fabriciomicheldenes/Momea/(list of files, drawings)

Other design files:
MomeaProbe12/Ae_System_12Bits_V5.dsn
