fabriciomicheldenes/Momea/MomeaProbe12/Amplificador.kicad_sch

## KiCad design MomeaProbe12/Amplificador.kicad_sch (2024-12-18)

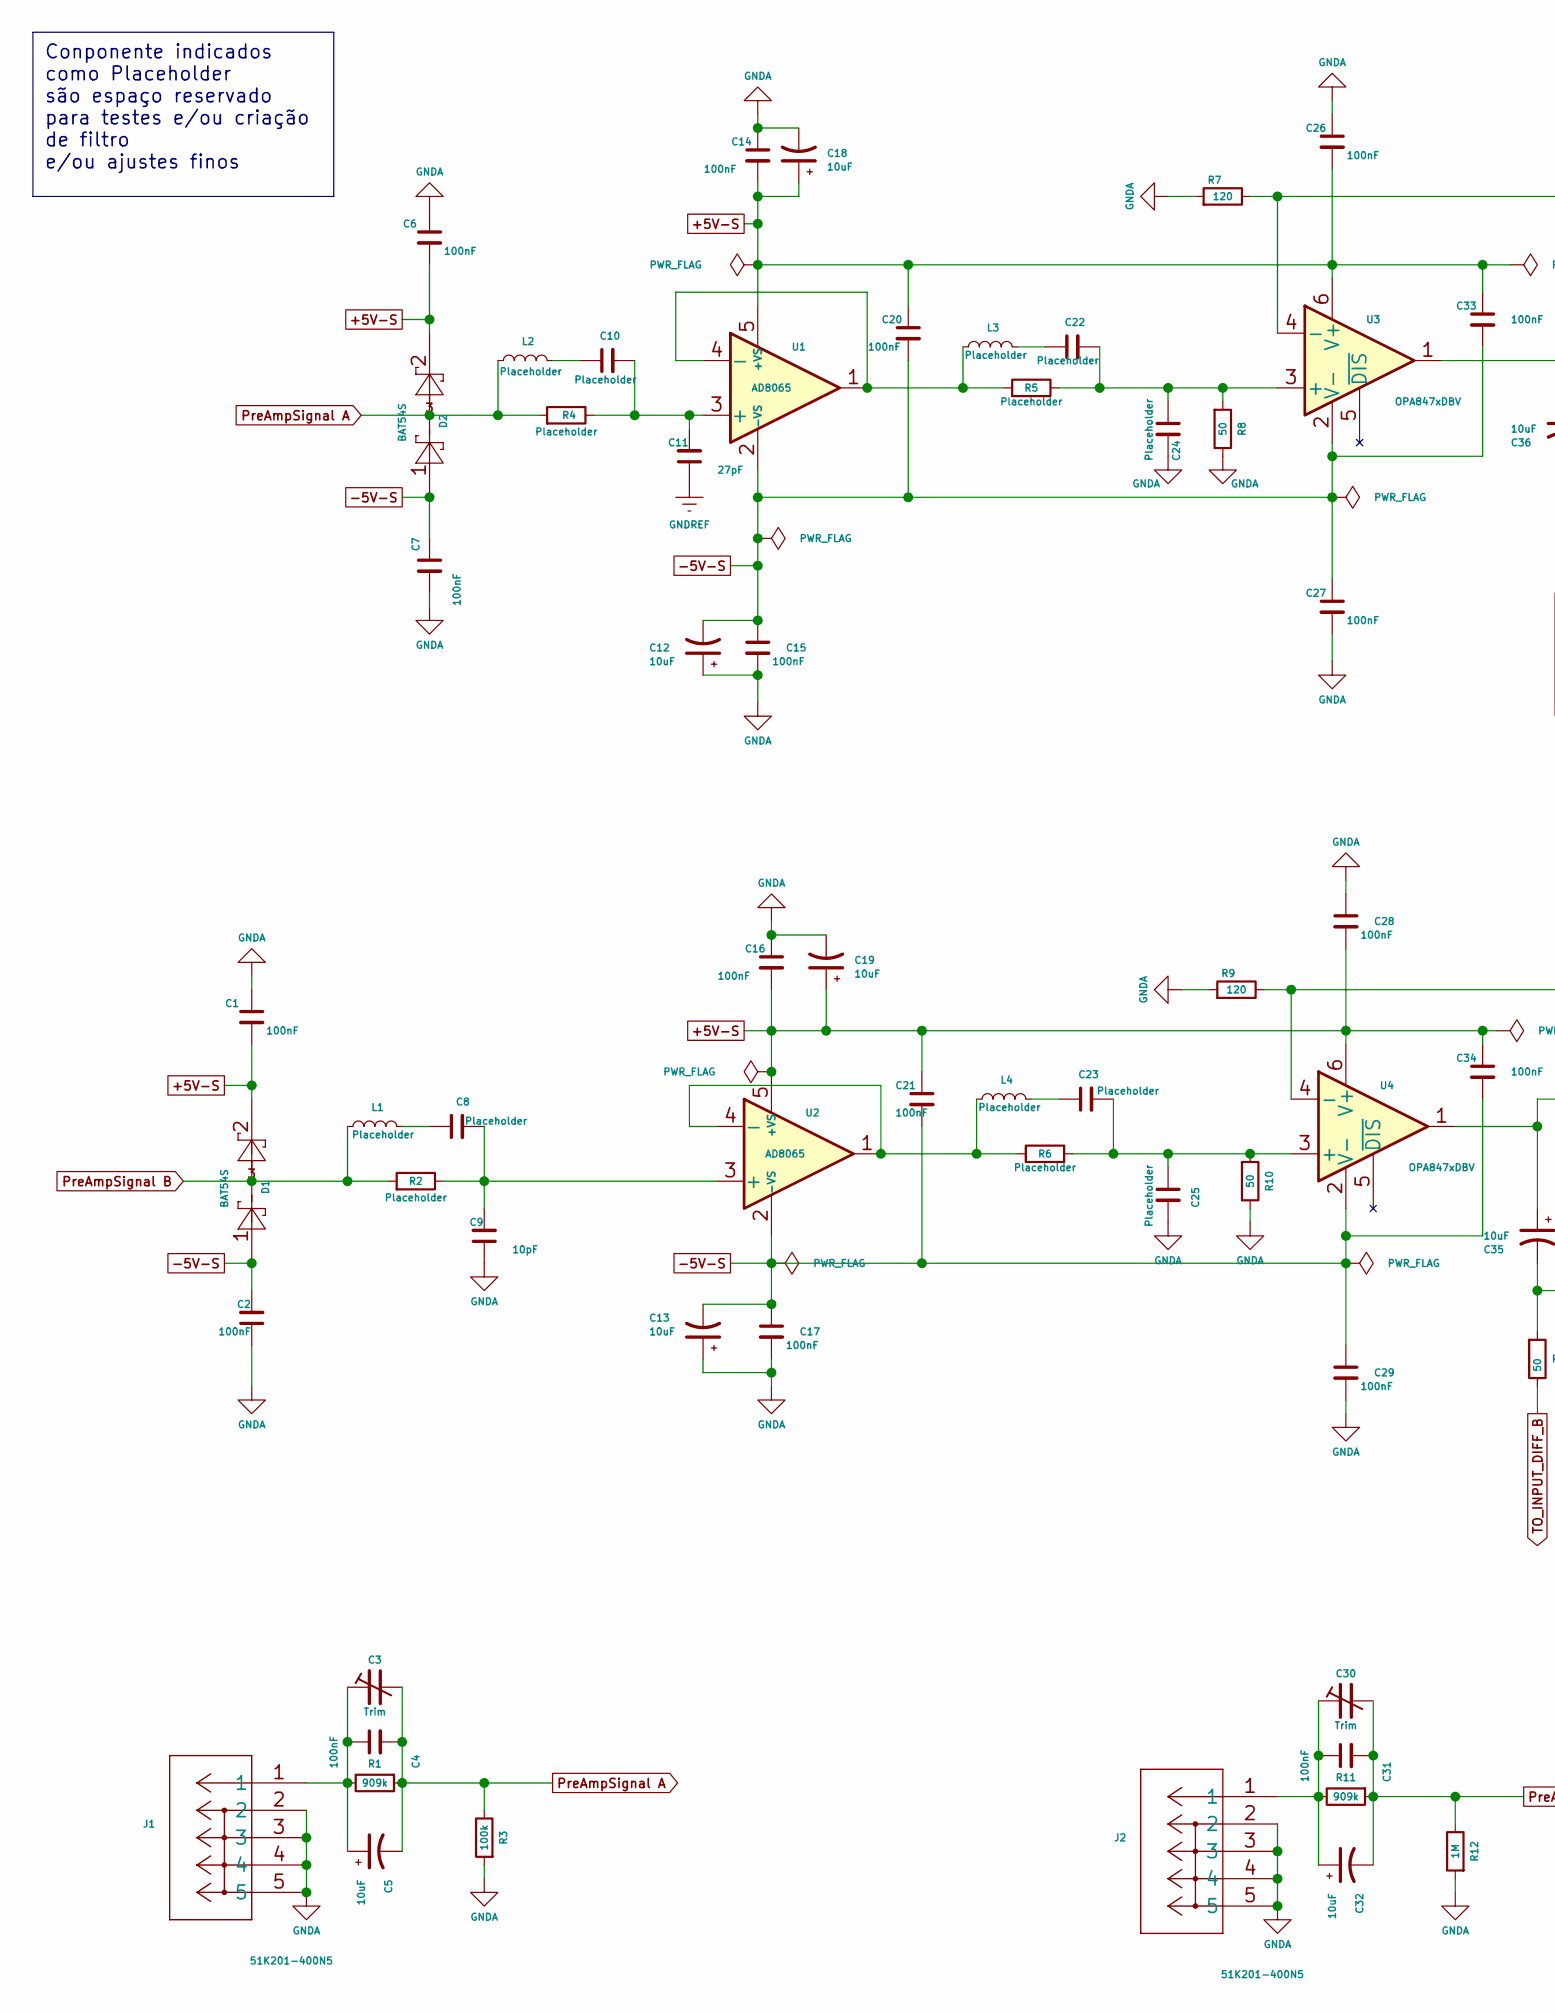
[picture p1: schematic Amplificador.kicad_sch, part in row 1, column 1]

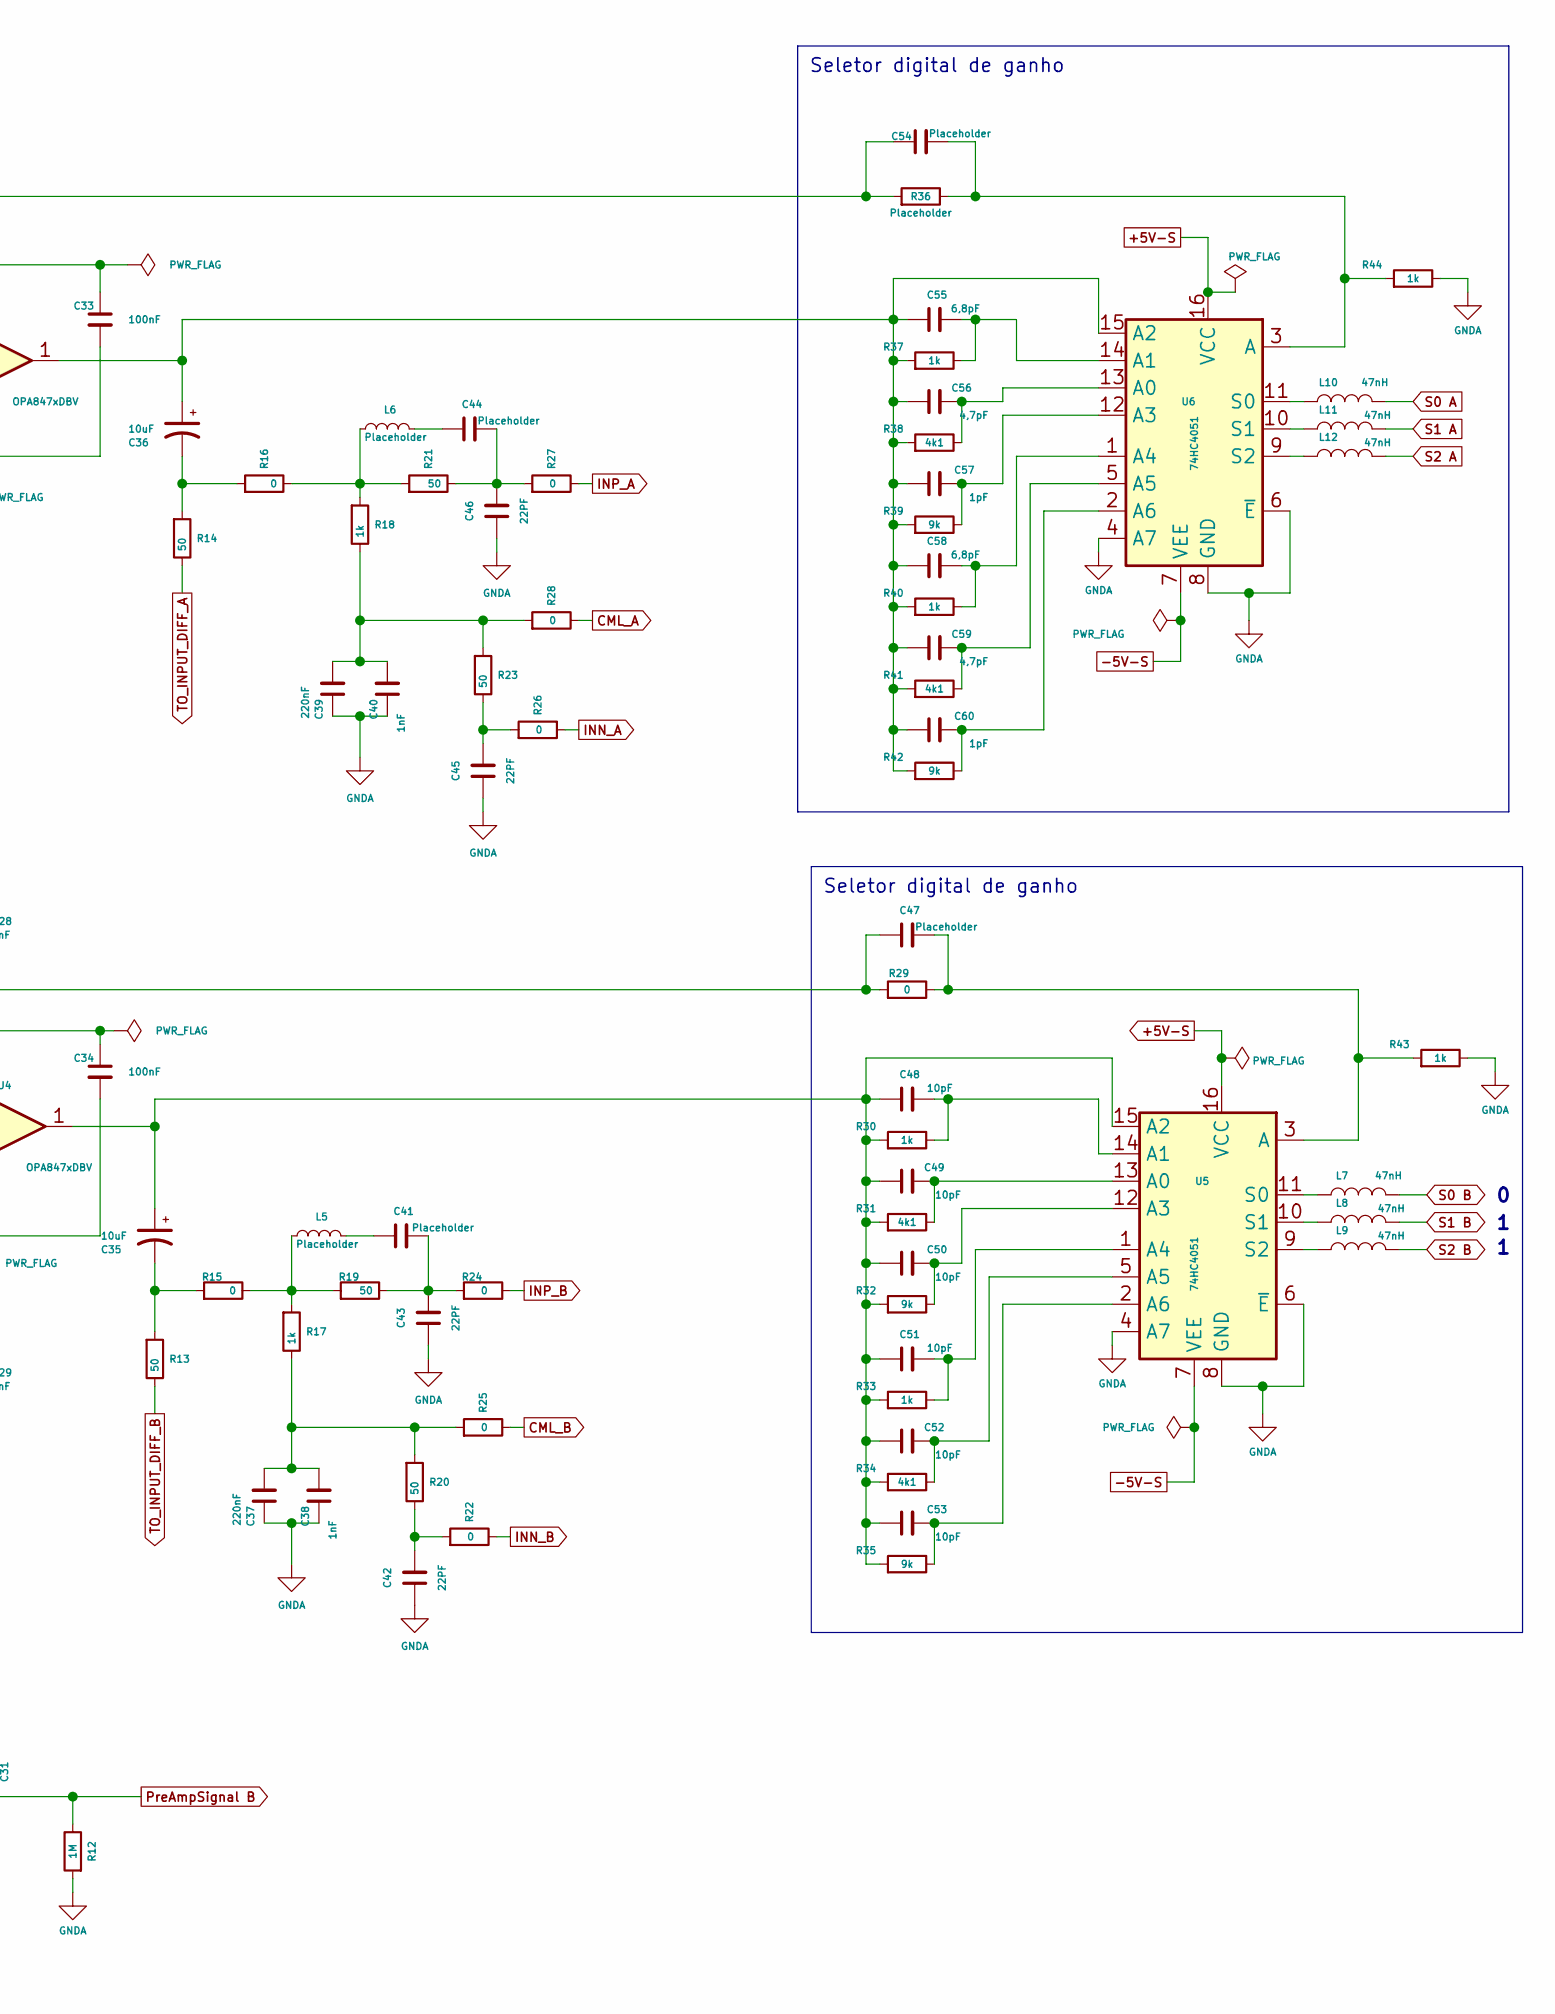
[picture p2: schematic Amplificador.kicad_sch, part in row 1, column 2]

Parts:
C1, C2, C4, C6, C7, C14, C15, C16, C17, C20, C21, C26, C27, C28, C29, C31, C33, C34: 100nF; C_0603_1608Metric
C3, C30: Trim; C_Trimmer_Murata_TZB4-B
C5, C12, C13, C18, C19, C32, C35, C36: 10uF; CP_Elec_4x3.9
C8, C10, C22, C23, C24, C25, C41, C44, C47, C54: Placeholder; C_0603_1608Metric
C9, C48, C49, C50, C51, C52, C53: 10pF; C_0603_1608Metric
C11: 27pF; C_0603_1608Metric
C37: 220nF; C_0603_1608Metric
C38, C40: 1nF; C_0603_1608Metric
C39: 220nF; C_0805_2012Metric
C42, C43, C45, C46: 22PF; C_0603_1608Metric
C55, C58: 6,8pF; C_0603_1608Metric
C56, C59: 4,7pF; C_0603_1608Metric
C57, C60: 1pF; C_0603_1608Metric
D1, D2: BAT54S; SOT-23
J1, J2: 51K201-400N5; CONN_51K201-400N5_RBG
L1, L2, L3, L4, L5, L6: Placeholder; L_0805_2012Metric
L7, L8, L9, L10, L11, L12: 47nH; L_0805_2012Metric
R1, R11: 909k; R_0603_1608Metric
R2, R4, R5, R6, R36: Placeholder; R_0603_1608Metric
R3: 100k; R_0603_1608Metric
R7, R9: 120; R_0603_1608Metric
R8, R10, R13, R14, R19, R20, R21, R23: 50; R_0603_1608Metric
R12: 1M; R_0603_1608Metric
R15, R16, R22, R24, R25, R26, R27, R28, R29: 0; R_0603_1608Metric
R17, R18, R30, R33, R37, R40, R43, R44: 1k; R_0603_1608Metric
R31, R34, R38, R41: 4k1; R_0603_1608Metric
R32, R35, R39, R42: 9k; R_0603_1608Metric
U1, U2: AD8065; AD8065ARTZ-R2
U3, U4: OPA847xDBV; SOT-23-6
U5, U6: 74HC4051; SOIC-16_4.55x10.3mm_P1.27mm

Connections:
+5V-S: C1.2, C6.2, C14.2, C16.2, C18.1, C19.1, C20.1, C21.1, C26.2, C28.2, C33.1, C34.1, D1.2, D2.2, U1.5 (+VS), U2.5 (+VS), U3.6 (V+), U4.6 (V+), U5.16 (VCC), U6.16 (VCC)
-5V-S: C2.2, C7.1, C12.2, C13.2, C15.1, C17.1, C20.2, C21.2, C27.1, C29.1, C33.2, C34.2, D1.1, D2.1, U1.2 (-VS), U2.2 (-VS), U3.2 (V-), U4.2 (V-), U5.7 (VEE), U6.7 (VEE)
CML_A: R28.2
CML_B: R25.2
GNDA: C1.1, C2.1, C6.1, C7.2, C9.1, C12.1, C13.1, C14.1, C15.2, C16.1, C17.2, C18.2, C19.2, C24.2, C25.2, C26.1, C27.2, C28.1, C29.2, C37.1, C38.1, C39.1, C40.1, C42.1, C43.1, C45.1, C46.1, J1.2, J1.3, J1.4, J1.5, J2.2, J2.3, J2.4, J2.5, R3.1, R7.1, R8.2, R9.1, R10.2, R12.1, R43.2, R44.2, U5.4 (A7), U5.6 (~E), U5.8 (GND), U6.4 (A7), U6.6 (~E), U6.8 (GND)
GNDREF: C11.1
INN_A: R26.2
INN_B: R22.2
INP_A: R27.2
INP_B: R24.2
unnamed: C3.1, C4.1, C5.1, J1.1, R1.2
unnamed: C8.1, L1.2
unnamed: C8.2, C9.2, R2.2, U2.3 (+)
unnamed: C10.1, L2.2
unnamed: C10.2, C11.2, R4.2, U1.3 (+)
unnamed: C22.1, L3.2
unnamed: C22.2, C24.1, R5.2, R8.1, U3.3 (+)
unnamed: C23.1, L4.2
unnamed: C23.2, C25.1, R6.2, R10.1, U4.3 (+)
unnamed: C30.1, C31.1, C32.1, J2.1, R11.2
unnamed: C35.1, C48.1, C49.1, C50.1, C51.1, C52.1, C53.1, R30.1, R31.1, R32.1, R33.1, R34.1, R35.1, U4.1, U5.15 (A2)
unnamed: C35.2, R13.1, R15.1
unnamed: C36.1, C55.1, C56.1, C57.1, C58.1, C59.1, C60.1, R37.1, R38.1, R39.1, R40.1, R41.1, R42.1, U3.1, U6.15 (A2)
unnamed: C36.2, R14.1, R16.1
unnamed: C37.2, C38.2, R17.2, R20.1, R25.1
unnamed: C39.2, C40.2, R18.2, R23.1, R28.1
unnamed: C41.1, L5.2
unnamed: C41.2, C43.2, R19.2, R24.1
unnamed: C42.2, R20.2, R22.1
unnamed: C44.1, L6.2
unnamed: C44.2, C46.2, R21.2, R27.1
unnamed: C45.2, R23.2, R26.1
unnamed: C47.1, R9.2, R29.1, U4.4 (-)
unnamed: C47.2, R29.2, R43.1, U5.3 (A)
unnamed: C48.2, R30.2, U5.14 (A1)
unnamed: C49.2, R31.2, U5.13 (A0)
unnamed: C50.2, R32.2, U5.12 (A3)
unnamed: C51.2, R33.2, U5.1 (A4)
unnamed: C52.2, R34.2, U5.5 (A5)
unnamed: C53.2, R35.2, U5.2 (A6)
unnamed: C54.1, R7.2, R36.1, U3.4 (-)
unnamed: C54.2, R36.2, R44.1, U6.3 (A)
unnamed: C55.2, R37.2, U6.14 (A1)
unnamed: C56.2, R38.2, U6.13 (A0)
unnamed: C57.2, R39.2, U6.12 (A3)
unnamed: C58.2, R40.2, U6.1 (A4)
unnamed: C59.2, R41.2, U6.5 (A5)
unnamed: C60.2, R42.2, U6.2 (A6)
unnamed: L3.1, R5.1, U1.1, U1.4 (-)
unnamed: L4.1, R6.1, U2.1, U2.4 (-)
unnamed: L5.1, R15.2, R17.1, R19.1
unnamed: L6.1, R16.2, R18.1, R21.1
unnamed: L7.1, U5.11 (S0)
unnamed: L8.1, U5.10 (S1)
unnamed: L9.1, U5.9 (S2)
unnamed: L10.1, U6.11 (S0)
unnamed: L11.1, U6.10 (S1)
unnamed: L12.1, U6.9 (S2)
PreAmpSignal A: C3.2, C4.2, C5.2, D2.3, L2.1, R1.1, R3.2, R4.1
PreAmpSignal B: C30.2, C31.2, C32.2, D1.3, L1.1, R2.1, R11.1, R12.2
S0 A: L10.2
S0 B: L7.2
S1 A: L11.2
S1 B: L8.2
S2 A: L12.2
S2 B: L9.2
TO_INPUT_DIFF_A: R14.2
TO_INPUT_DIFF_B: R13.2

Notes on the sheet:
Seletor digital de ganho
Conponente indicados como Placeholder são espaço reservado para testes e/ou criação de filtro e/ou ajustes finos
