fabriciomicheldenes/Momea/MomeaProbe12/ConversorAnalogicoDigital.kicad_sch

## KiCad design MomeaProbe12/ConversorAnalogicoDigital.kicad_sch (2024-12-18)

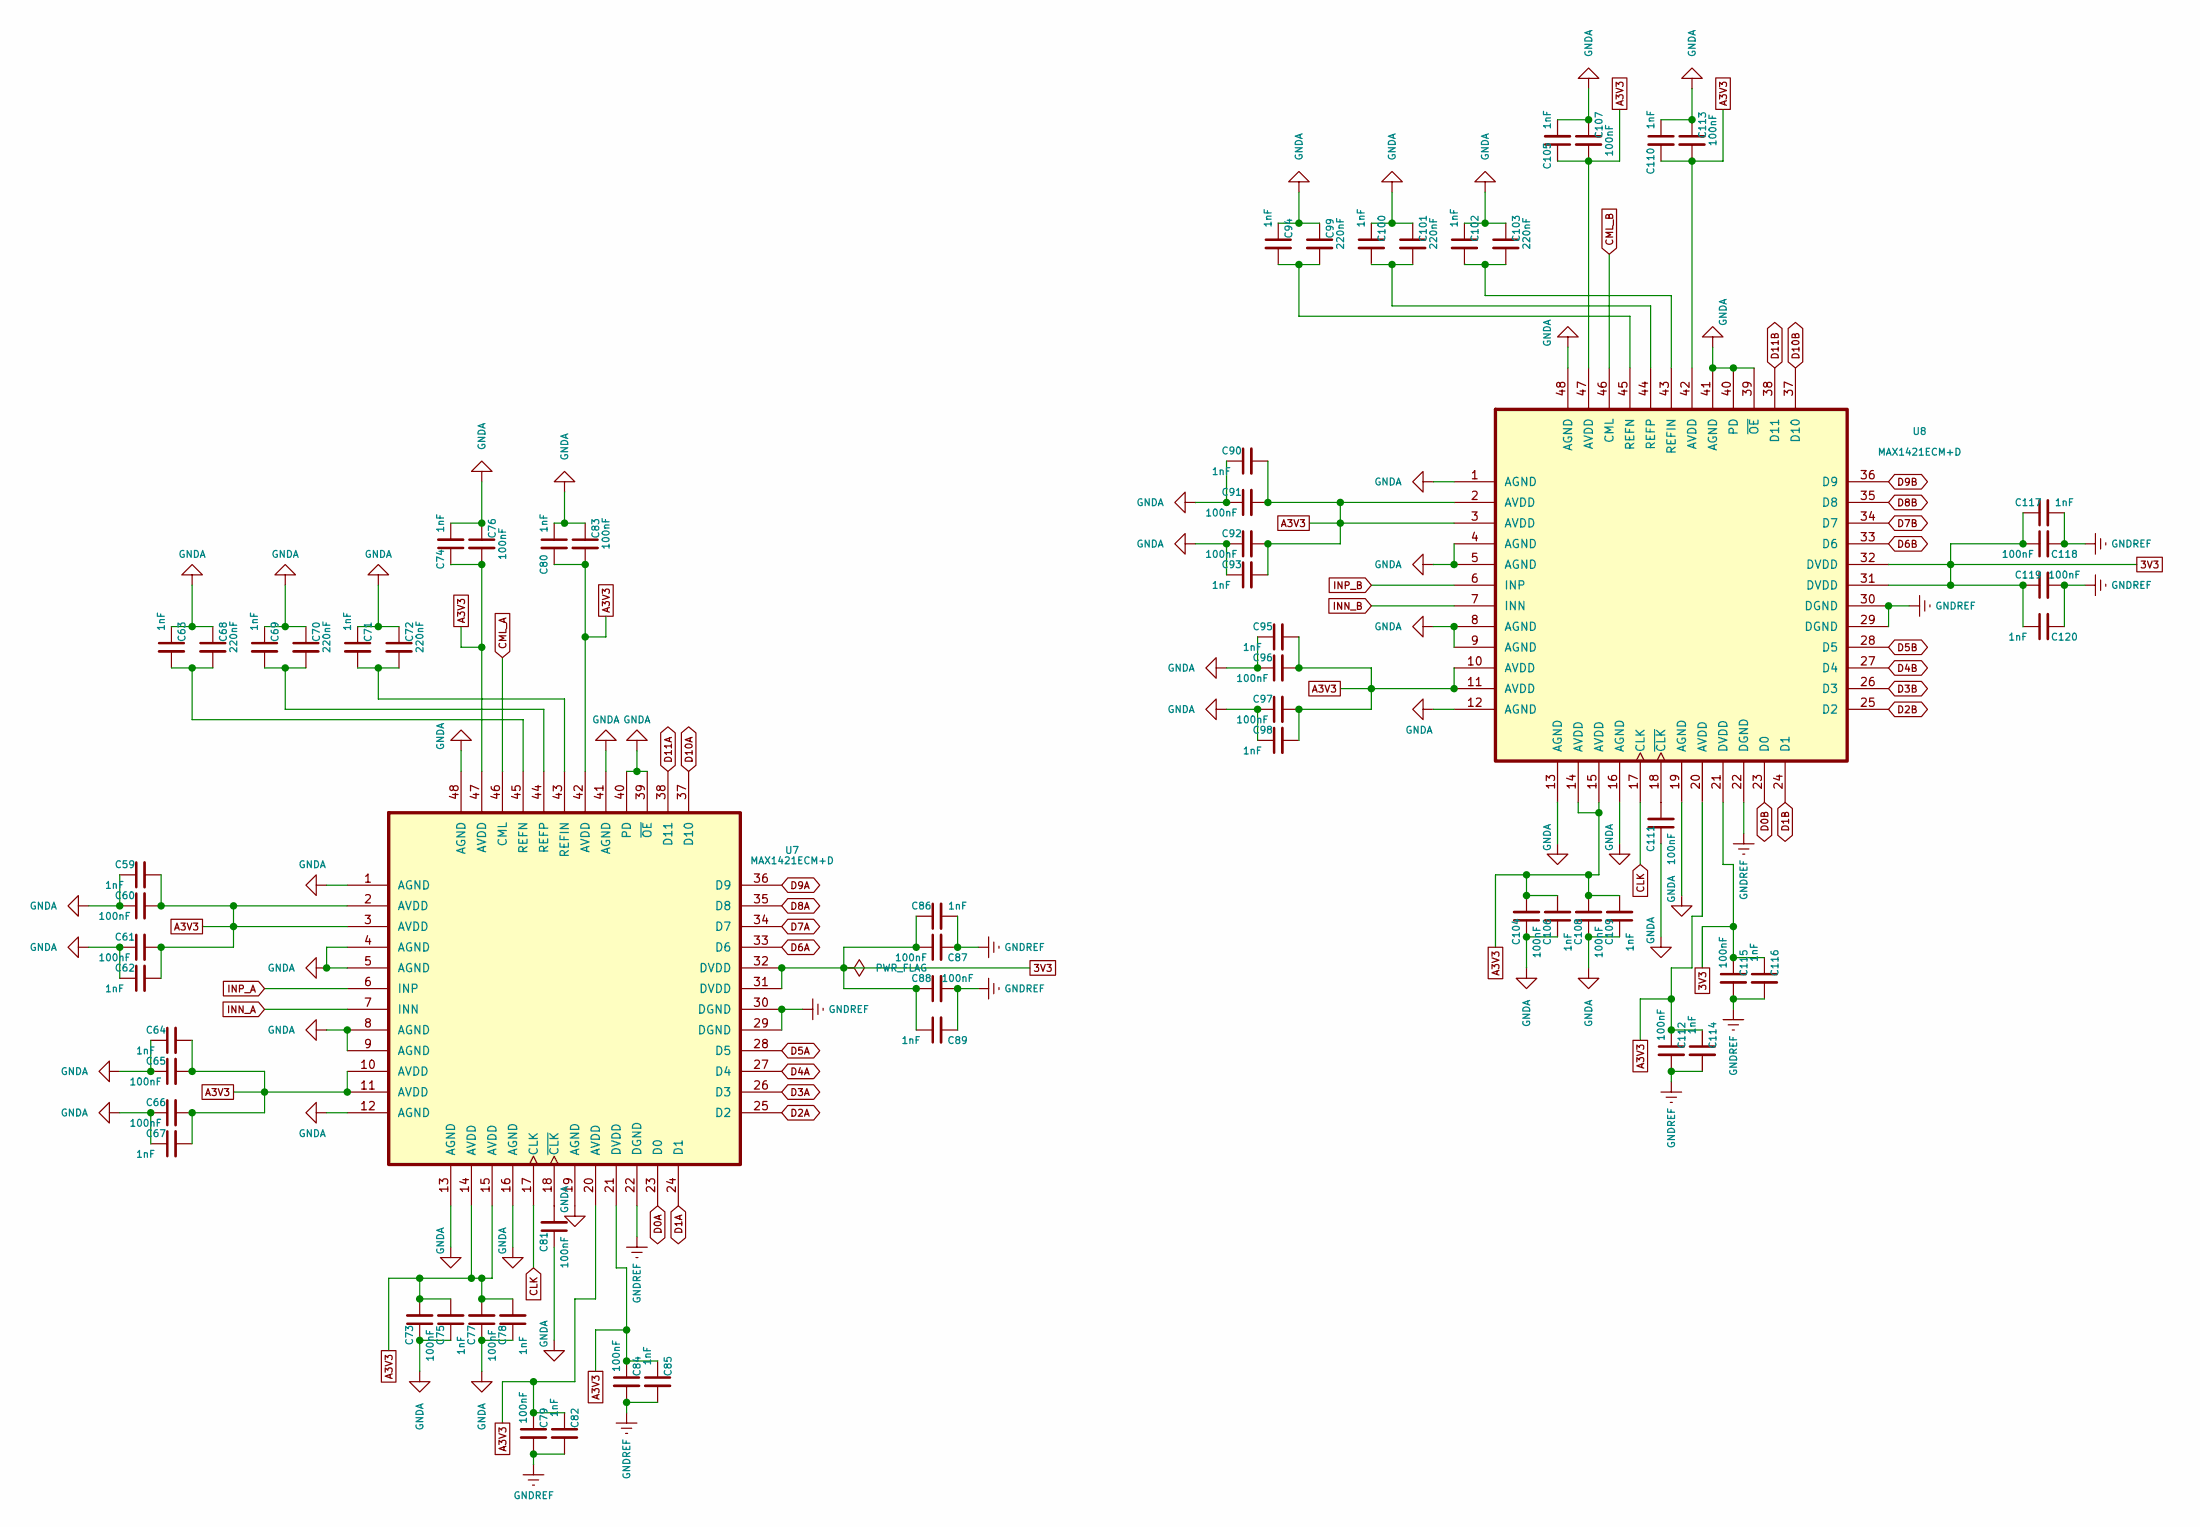
[picture p3: schematic ConversorAnalogicoDigital.kicad_sch]

Parts:
C59, C62, C63, C64, C67, C69, C71, C74, C75, C78, C80, C82, C85, C86, C89, C90, C93, C94, C95, C98, C100, C102, C105, C106, C109, C110, C114, C116, C117, C120: 1nF; C_0603_1608Metric
C60, C61, C65, C66, C73, C76, C77, C79, C81, C83, C84, C87, C88, C91, C92, C96, C97, C104, C107, C108, C111, C112, C113, C115, C118, C119: 100nF; C_0603_1608Metric
C68, C70, C72, C99, C101, C103: 220nF; C_0805_2012Metric
U7, U8: MAX1421ECM+D; QFP50P900X900X160-48N

Connections:
3V3: C86.1, C87.1, C88.1, C89.1, C115.1, C116.1, C117.1, C118.1, C119.1, C120.1, U7.31 (DVDD), U7.32 (DVDD), U8.21 (DVDD), U8.31 (DVDD), U8.32 (DVDD)
A3V3: C59.2, C60.2, C61.2, C62.2, C64.2, C65.2, C66.2, C67.2, C73.2, C74.1, C75.2, C76.2, C77.2, C78.2, C79.1, C80.2, C82.1, C83.2, C84.1, C85.1, C90.2, C91.2, C92.2, C93.2, C95.2, C96.2, C97.2, C98.2, C104.2, C105.1, C106.2, C107.2, C108.2, C109.2, C110.2, C112.1, C113.2, C114.1, U7.2 (AVDD), U7.3 (AVDD), U7.10 (AVDD), U7.11 (AVDD), U7.14 (AVDD), U7.15 (AVDD), U7.20 (AVDD), U7.21 (DVDD), U7.42 (AVDD), U7.47 (AVDD), U8.2 (AVDD), U8.3 (AVDD), U8.10 (AVDD), U8.11 (AVDD), U8.14 (AVDD), U8.15 (AVDD), U8.20 (AVDD), U8.42 (AVDD), U8.47 (AVDD)
CLK: U7.17 (CLK), U8.17 (CLK)
CML_A: U7.46 (CML)
CML_B: U8.46 (CML)
D0A: U7.23 (D0)
D0B: U8.23 (D0)
D1A: U7.24 (D1)
D1B: U8.24 (D1)
D2A: U7.25 (D2)
D2B: U8.25 (D2)
D3A: U7.26 (D3)
D3B: U8.26 (D3)
D4A: U7.27 (D4)
D4B: U8.27 (D4)
D5A: U7.28 (D5)
D5B: U8.28 (D5)
D6A: U7.33 (D6)
D6B: U8.33 (D6)
D7A: U7.34 (D7)
D7B: U8.34 (D7)
D8A: U7.35 (D8)
D8B: U8.35 (D8)
D9A: U7.36 (D9)
D9B: U8.36 (D9)
D10A: U7.37 (D10)
D10B: U8.37 (D10)
D11A: U7.38 (D11)
D11B: U8.38 (D11)
GNDA: C59.1, C60.1, C61.1, C62.1, C63.1, C64.1, C65.1, C66.1, C67.1, C68.1, C69.1, C70.1, C71.1, C72.1, C73.1, C74.2, C75.1, C76.1, C77.1, C78.1, C80.1, C81.1, C83.1, C90.1, C91.1, C92.1, C93.1, C94.1, C95.1, C96.1, C97.1, C98.1, C99.1, C100.1, C101.1, C102.1, C103.1, C104.1, C105.2, C106.1, C107.1, C108.1, C109.1, C110.1, C111.1, C113.1, U7.1 (AGND), U7.4 (AGND), U7.5 (AGND), U7.8 (AGND), U7.9 (AGND), U7.12 (AGND), U7.13 (AGND), U7.16 (AGND), U7.19 (AGND), U7.39 (~OE), U7.40 (PD), U7.41 (AGND), U7.48 (AGND), U8.1 (AGND), U8.4 (AGND), U8.5 (AGND), U8.8 (AGND), U8.9 (AGND), U8.12 (AGND), U8.13 (AGND), U8.16 (AGND), U8.19 (AGND), U8.39 (~OE), U8.40 (PD), U8.41 (AGND), U8.48 (AGND)
GNDREF: C79.2, C82.2, C84.2, C85.2, C86.2, C87.2, C88.2, C89.2, C112.2, C114.2, C115.2, C116.2, C117.2, C118.2, C119.2, C120.2, U7.22 (DGND), U7.29 (DGND), U7.30 (DGND), U8.22 (DGND), U8.29 (DGND), U8.30 (DGND)
INN_A: U7.7 (INN)
INN_B: U8.7 (INN)
INP_A: U7.6 (INP)
INP_B: U8.6 (INP)
unnamed: C63.2, C68.2, U7.45 (REFN)
unnamed: C69.2, C70.2, U7.44 (REFP)
unnamed: C71.2, C72.2, U7.43 (REFIN)
unnamed: C81.2, U7.18 (~CLK)
unnamed: C94.2, C99.2, U8.45 (REFN)
unnamed: C100.2, C101.2, U8.44 (REFP)
unnamed: C102.2, C103.2, U8.43 (REFIN)
unnamed: C111.2, U8.18 (~CLK)
