fabriciomicheldenes/Momea/MomeaProbe12/ConversorAnalogicoDigital_A.kicad_sch

## KiCad design MomeaProbe12/ConversorAnalogicoDigital_A.kicad_sch (2024-12-18)

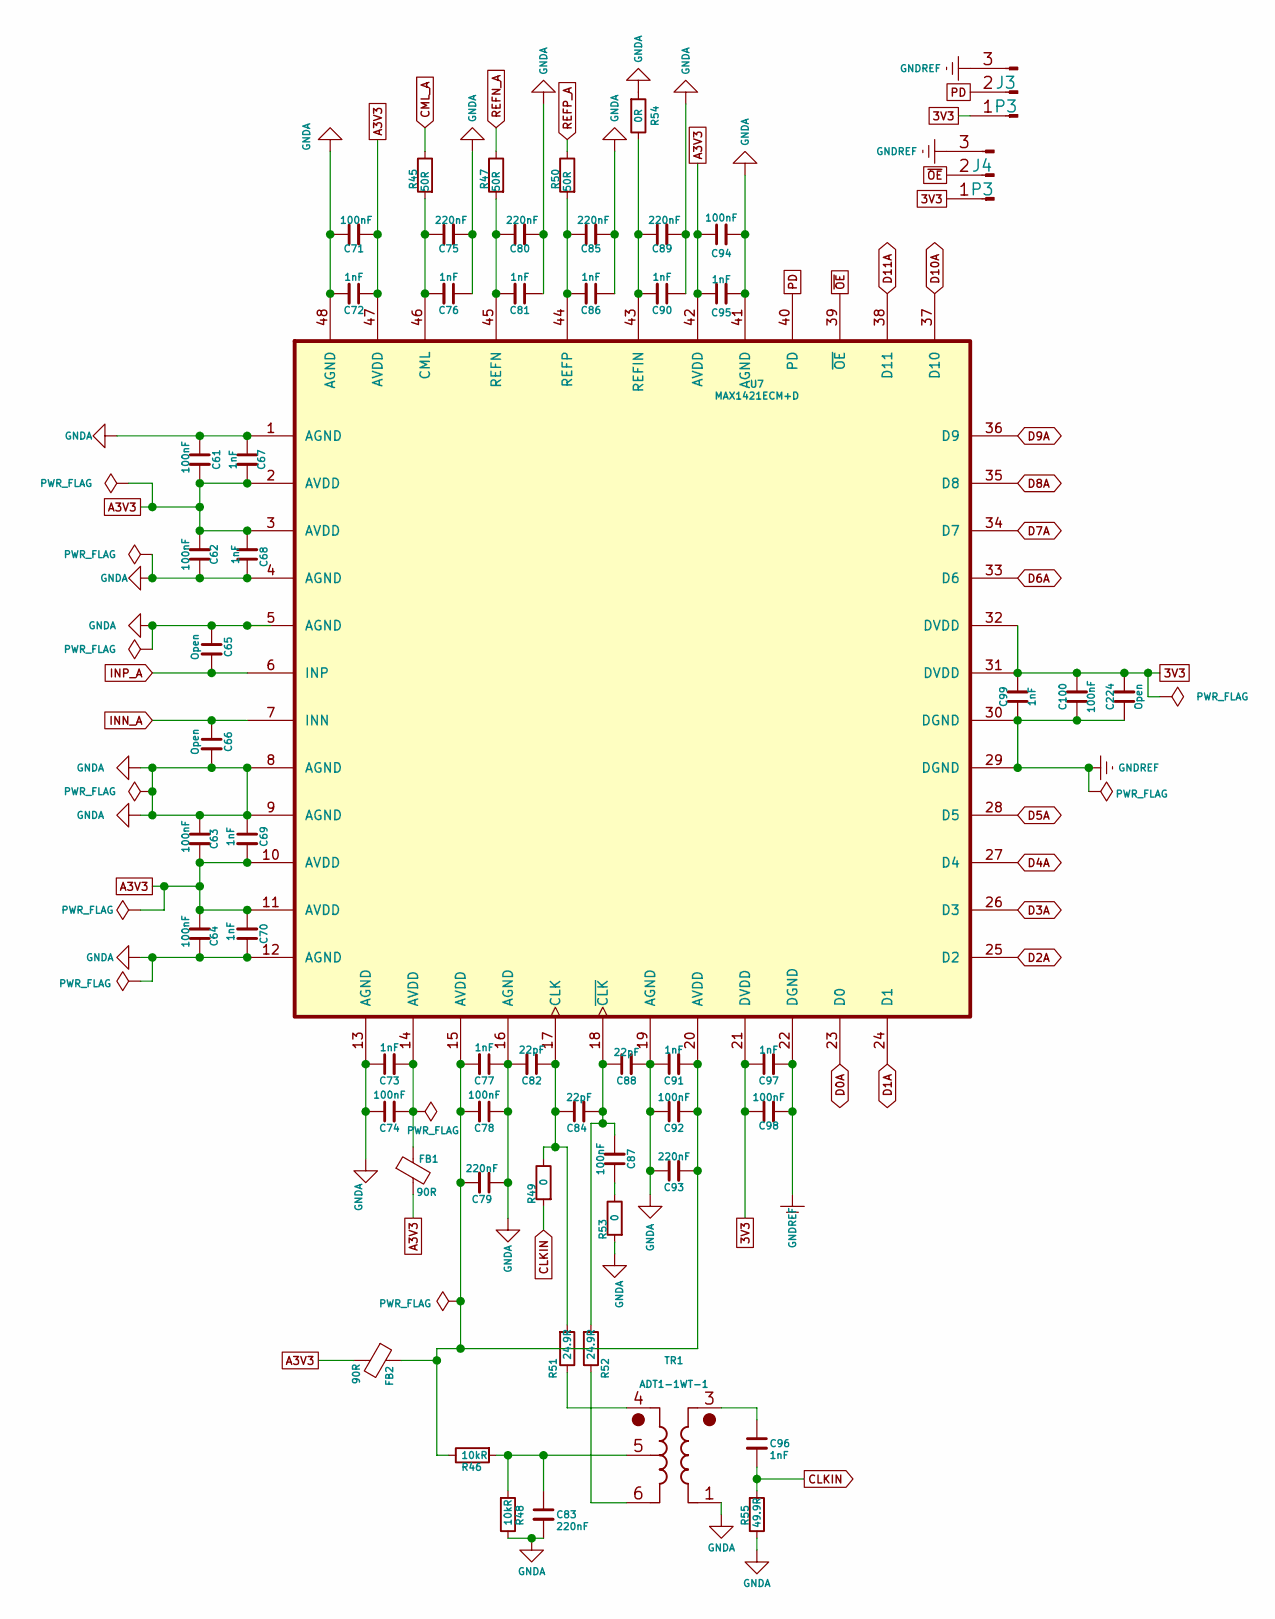
[picture p4: schematic ConversorAnalogicoDigital_A.kicad_sch, part in row 1, column 1]

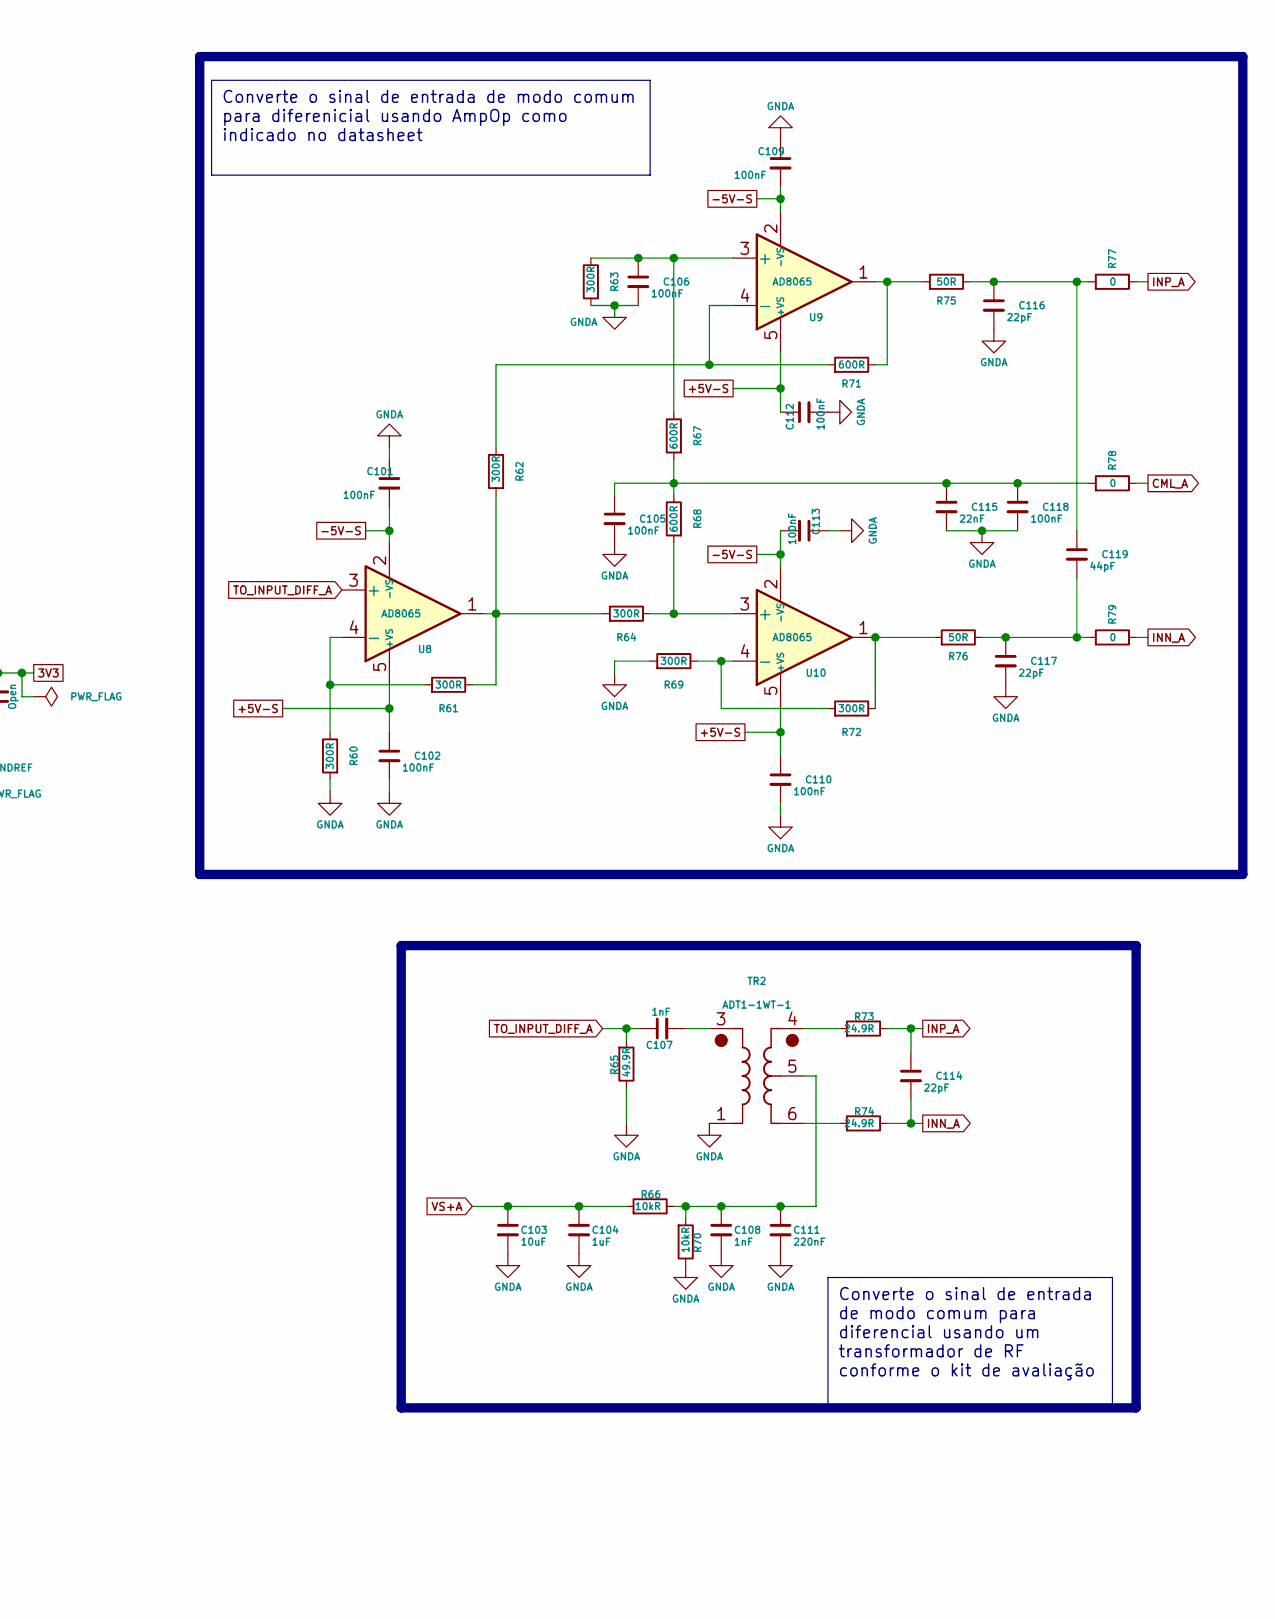
[picture p5: schematic ConversorAnalogicoDigital_A.kicad_sch, part in row 1, column 2]

Parts:
C61, C62, C63, C64, C71, C74, C78, C87, C92, C94, C98, C100, C101, C102, C105, C106, C109, C110, C112, C113, C118: 100nF; C_0603_1608Metric
C65, C66: Open; C_0402_1005Metric
C67, C68, C69, C70, C72, C73, C76, C77, C81, C86, C90, C91, C95, C97, C99, C107: 1nF; C_0402_1005Metric
C75, C79, C80, C83, C85, C89, C93, C111: 220nF; C_0603_1608Metric
C82, C84, C88, C114: 22pF; C_0402_1005Metric
C96: 1nF; D_0402_1005Metric
C103: 10uF; C_1206_3216Metric
C104: 1uF; C_1206_3216Metric
C108: 1nF; C_0603_1608Metric
C115: 22nF; C_0603_1608Metric
C116, C117: 22pF; C_0603_1608Metric
C119: 44pF; C_0603_1608Metric
C224: Open; C_0603_1608Metric
FB1, FB2: 90R; L_1206_3216Metric
J3, J4: P3; PinHeader_1x03_P2.54mm_Vertical
R45, R47, R50, R75, R76: 50R; R_0603_1608Metric
R46, R48, R66, R70: 10kR; R_0805_2012Metric
R49, R53, R77, R78, R79: 0; R_0603_1608Metric
R51, R52, R73, R74: 24.9R; R_0805_2012Metric
R54: 0R; R_0603_1608Metric
R55, R65: 49.9R; R_0603_1608Metric
R60, R61, R62, R63, R64, R69, R72: 300R; R_0603_1608Metric
R67, R68, R71: 600R; R_0603_1608Metric
TR1, TR2: ADT1-1WT-1; T11TKK81
U7: MAX1421ECM+D; MAX1421ECM_D
U8, U9, U10: AD8065; AD8065ARTZ-R2

Connections:
3V3: C97.1, C98.1, C99.2, C100.2, C224.2, J3.1, J4.1, U7.21 (DVDD), U7.31 (DVDD), U7.32 (DVDD)
+5V-S: C102.1, C110.1, C112.1, U8.5 (+VS), U9.5 (+VS), U10.5 (+VS)
-5V-S: C101.2, C109.2, C113.2, U8.2 (-VS), U9.2 (-VS), U10.2 (-VS)
A3V3: C61.2, C62.2, C63.2, C64.2, C67.2, C68.2, C69.2, C70.2, C71.2, C72.1, C94.1, C95.1, FB1.2, FB2.2, U7.2 (AVDD), U7.3 (AVDD), U7.10 (AVDD), U7.11 (AVDD), U7.42 (AVDD), U7.47 (AVDD)
CLKIN: C96.2, R49.1, R55.1
CML_A: R45.2, R78.2
D0A: U7.23 (D0)
D1A: U7.24 (D1)
D2A: U7.25 (D2)
D3A: U7.26 (D3)
D4A: U7.27 (D4)
D5A: U7.28 (D5)
D6A: U7.33 (D6)
D7A: U7.34 (D7)
D8A: U7.35 (D8)
D9A: U7.36 (D9)
D10A: U7.37 (D10)
D11A: U7.38 (D11)
GNDA: C61.1, C62.1, C63.1, C64.1, C65.1, C66.2, C67.1, C68.1, C69.1, C70.1, C71.1, C72.2, C73.1, C74.1, C75.2, C76.1, C77.1, C78.1, C79.1, C80.2, C81.1, C82.2, C83.2, C85.2, C86.1, C88.2, C89.2, C90.1, C91.1, C92.1, C93.1, C94.2, C95.2, C101.1, C102.2, C103.2, C104.2, C105.2, C106.2, C108.2, C109.1, C110.2, C111.2, C112.2, C113.1, C115.2, C116.2, C117.2, C118.2, R48.2, R53.1, R54.1, R55.2, R60.1, R63.1, R65.2, R69.1, R70.2, TR1.1, TR2.1, U7.1 (AGND), U7.4 (AGND), U7.5 (AGND), U7.8 (AGND), U7.9 (AGND), U7.12 (AGND), U7.13 (AGND), U7.16 (AGND), U7.19 (AGND), U7.41 (AGND), U7.48 (AGND)
GNDREF: C97.2, C98.2, C99.1, C100.1, C224.1, J3.3, J4.3, U7.22 (DGND), U7.29 (DGND), U7.30 (DGND)
INN_A: C66.1, C114.2, R74.2, R79.2, U7.7 (INN)
INP_A: C65.2, C114.1, R73.2, R77.2, U7.6 (INP)
unnamed: C73.2, C74.2, FB1.1, U7.14 (AVDD)
unnamed: C75.1, C76.2, R45.1, U7.46 (CML)
unnamed: C77.2, C78.2, C79.2, C91.2, C92.2, C93.2, FB2.1, R46.2, U7.15 (AVDD), U7.20 (AVDD)
unnamed: C80.1, C81.2, R47.1, U7.45 (REFN)
unnamed: C82.1, C84.1, R49.2, R51.1, U7.17 (CLK)
unnamed: C83.1, R46.1, R48.1, TR1.5
unnamed: C84.2, C87.2, C88.1, R52.1, U7.18 (~CLK)
unnamed: C85.1, C86.2, R50.1, U7.44 (REFP)
unnamed: C87.1, R53.2
unnamed: C89.1, C90.2, R54.2, U7.43 (REFIN)
unnamed: C96.1, TR1.3
unnamed: C105.1, C115.1, C118.1, R67.1, R68.2, R78.1
unnamed: C106.1, R63.2, R67.2, U9.3 (+)
unnamed: C107.2, TR2.3
unnamed: C108.1, C111.1, R66.2, R70.1, TR2.5
unnamed: C116.1, C119.1, R75.2, R77.1
unnamed: C117.1, C119.2, R76.2, R79.1
unnamed: R51.2, TR1.4
unnamed: R52.2, TR1.6
unnamed: R60.2, R61.1, U8.4 (-)
unnamed: R61.2, R62.1, R64.1, U8.1
unnamed: R62.2, R71.1, U9.4 (-)
unnamed: R64.2, R68.1, U10.3 (+)
unnamed: R69.2, R72.1, U10.4 (-)
unnamed: R71.2, R75.1, U9.1
unnamed: R72.2, R76.1, U10.1
unnamed: R73.1, TR2.4
unnamed: R74.1, TR2.6
PD: J3.2, U7.40 (PD)
REFN_A: R47.2
REFP_A: R50.2
TO_INPUT_DIFF_A: C107.1, R65.1, U8.3 (+)
VS+A: C103.1, C104.1, R66.1
~OE: J4.2, U7.39 (~OE)

Notes on the sheet:
Converte o sinal de entrada de modo comum para diferenicial usando AmpOp como indicado no datasheet
Converte o sinal de entrada de modo comum para diferencial usando um transformador de RF conforme o kit de avaliação
