fabriciomicheldenes/Momea/MomeaProbe12/ConversorAnalogicoDigital_B.kicad_sch

## KiCad design MomeaProbe12/ConversorAnalogicoDigital_B.kicad_sch (2024-12-18)

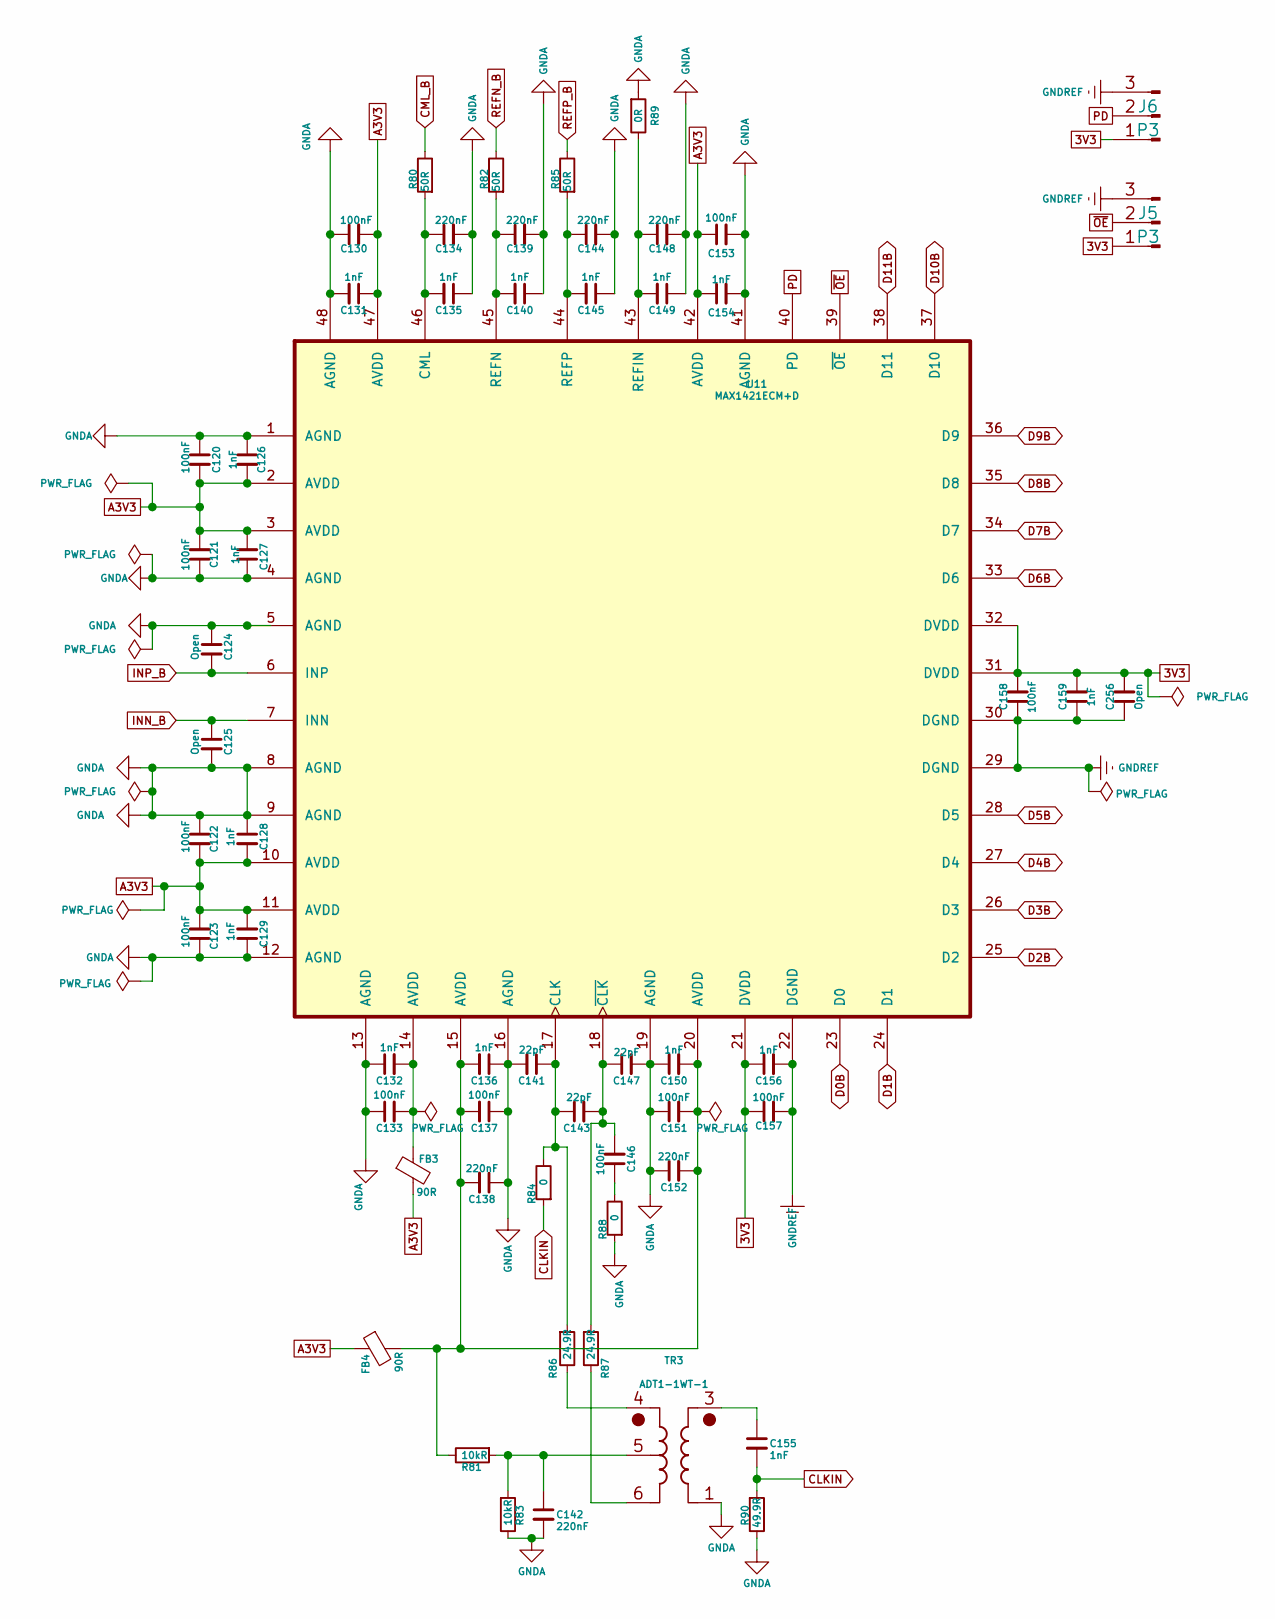
[picture p6: schematic ConversorAnalogicoDigital_B.kicad_sch, part in row 1, column 1]

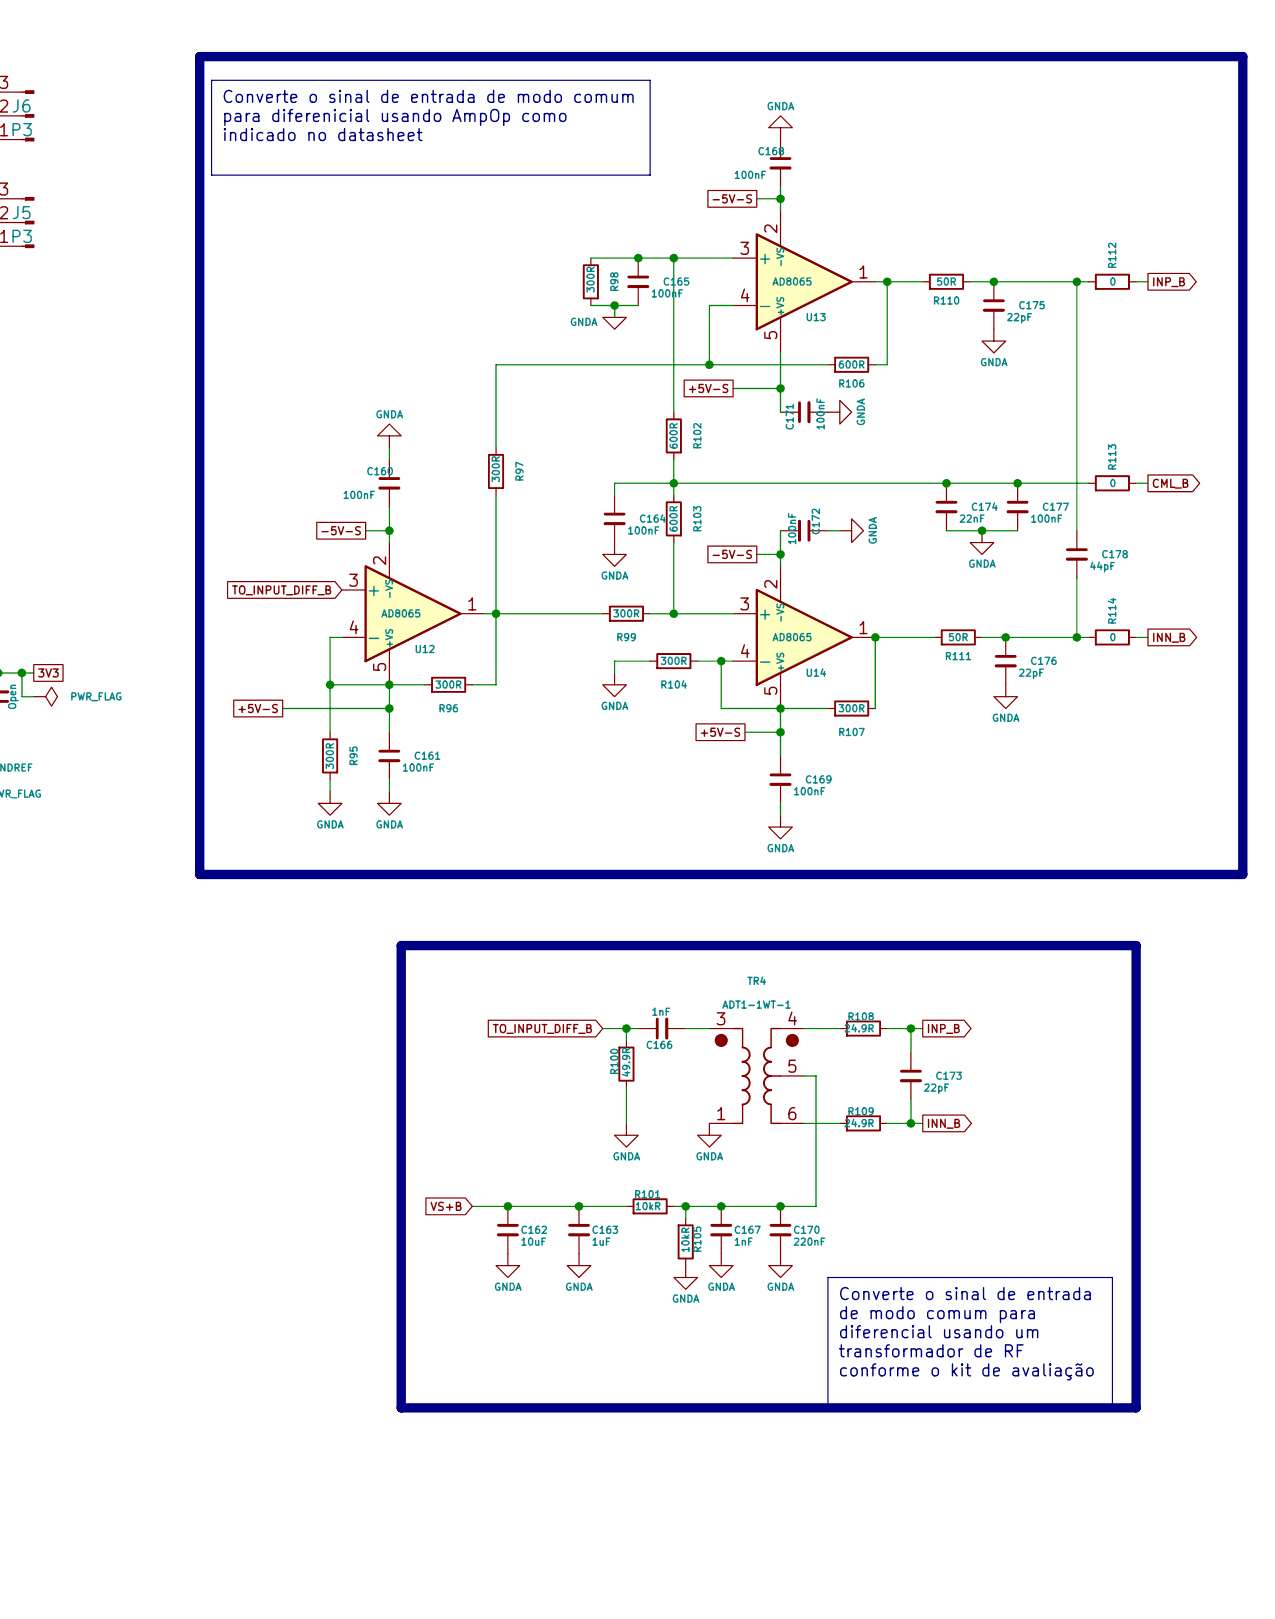
[picture p7: schematic ConversorAnalogicoDigital_B.kicad_sch, part in row 1, column 2]

Parts:
C120, C121, C122, C123, C130, C133, C137, C146, C151, C153, C157, C158, C160, C161, C164, C165, C168, C169, C171, C172, C177: 100nF; C_0603_1608Metric
C124, C125: Open; C_0402_1005Metric
C126, C127, C128, C129, C131, C132, C135, C136, C140, C145, C149, C150, C154, C155, C156, C159: 1nF; C_0402_1005Metric
C134, C138, C139, C142, C144, C148, C152, C170: 220nF; C_0603_1608Metric
C141, C143, C147, C173: 22pF; C_0402_1005Metric
C162: 10uF; C_1206_3216Metric
C163: 1uF; C_1206_3216Metric
C166, C167: 1nF; C_0603_1608Metric
C174: 22nF; C_0603_1608Metric
C175, C176: 22pF; C_0603_1608Metric
C178: 44pF; C_0603_1608Metric
C256: Open; C_0603_1608Metric
FB3, FB4: 90R; L_1206_3216Metric
J5, J6: P3; PinHeader_1x03_P2.54mm_Vertical
R80, R82, R85, R110, R111: 50R; R_0603_1608Metric
R81, R83, R101, R105: 10kR; R_0805_2012Metric
R84, R88, R112, R113, R114: 0; R_0603_1608Metric
R86, R87, R108, R109: 24.9R; R_0805_2012Metric
R89: 0R; R_0603_1608Metric
R90, R100: 49.9R; R_0603_1608Metric
R95, R96, R97, R98, R99, R104, R107: 300R; R_0603_1608Metric
R102, R103, R106: 600R; R_0603_1608Metric
TR3, TR4: ADT1-1WT-1; T11TKK81
U11: MAX1421ECM+D; MAX1421ECM_D
U12, U13, U14: AD8065; AD8065ARTZ-R2

Connections:
3V3: C156.1, C157.1, C158.2, C159.2, C256.2, J5.1, J6.1, U11.21 (DVDD), U11.31 (DVDD), U11.32 (DVDD)
+5V-S: C161.1, C169.1, C171.1, R95.2, R96.1, R104.2, R107.1, U12.4 (-), U12.5 (+VS), U13.5 (+VS), U14.4 (-), U14.5 (+VS)
-5V-S: C160.2, C168.2, C172.2, U12.2 (-VS), U13.2 (-VS), U14.2 (-VS)
A3V3: C120.2, C121.2, C122.2, C123.2, C126.2, C127.2, C128.2, C129.2, C130.2, C131.1, C153.1, C154.1, FB3.2, FB4.1, U11.2 (AVDD), U11.3 (AVDD), U11.10 (AVDD), U11.11 (AVDD), U11.42 (AVDD), U11.47 (AVDD)
CLKIN: C155.2, R84.1, R90.1
CML_B: R80.2, R113.2
D0B: U11.23 (D0)
D1B: U11.24 (D1)
D2B: U11.25 (D2)
D3B: U11.26 (D3)
D4B: U11.27 (D4)
D5B: U11.28 (D5)
D6B: U11.33 (D6)
D7B: U11.34 (D7)
D8B: U11.35 (D8)
D9B: U11.36 (D9)
D10B: U11.37 (D10)
D11B: U11.38 (D11)
GNDA: C120.1, C121.1, C122.1, C123.1, C124.1, C125.2, C126.1, C127.1, C128.1, C129.1, C130.1, C131.2, C132.1, C133.1, C134.2, C135.1, C136.1, C137.1, C138.1, C139.2, C140.1, C141.2, C142.2, C144.2, C145.1, C147.2, C148.2, C149.1, C150.1, C151.1, C152.1, C153.2, C154.2, C160.1, C161.2, C162.2, C163.2, C164.2, C165.2, C167.2, C168.1, C169.2, C170.2, C171.2, C172.1, C174.2, C175.2, C176.2, C177.2, R83.2, R88.1, R89.1, R90.2, R95.1, R98.1, R100.2, R104.1, R105.2, TR3.1, TR4.1, U11.1 (AGND), U11.4 (AGND), U11.5 (AGND), U11.8 (AGND), U11.9 (AGND), U11.12 (AGND), U11.13 (AGND), U11.16 (AGND), U11.19 (AGND), U11.41 (AGND), U11.48 (AGND)
GNDREF: C156.2, C157.2, C158.1, C159.1, C256.1, J5.3, J6.3, U11.22 (DGND), U11.29 (DGND), U11.30 (DGND)
INN_B: C125.1, C173.2, R109.2, R114.2, U11.7 (INN)
INP_B: C124.2, C173.1, R108.2, R112.2, U11.6 (INP)
unnamed: C132.2, C133.2, FB3.1, U11.14 (AVDD)
unnamed: C134.1, C135.2, R80.1, U11.46 (CML)
unnamed: C136.2, C137.2, C138.2, C150.2, C151.2, C152.2, FB4.2, R81.2, U11.15 (AVDD), U11.20 (AVDD)
unnamed: C139.1, C140.2, R82.1, U11.45 (REFN)
unnamed: C141.1, C143.1, R84.2, R86.1, U11.17 (CLK)
unnamed: C142.1, R81.1, R83.1, TR3.5
unnamed: C143.2, C146.2, C147.1, R87.1, U11.18 (~CLK)
unnamed: C144.1, C145.2, R85.1, U11.44 (REFP)
unnamed: C146.1, R88.2
unnamed: C148.1, C149.2, R89.2, U11.43 (REFIN)
unnamed: C155.1, TR3.3
unnamed: C164.1, C174.1, C177.1, R102.1, R103.2, R113.1
unnamed: C165.1, R98.2, R102.2, U13.3 (+)
unnamed: C166.2, TR4.3
unnamed: C167.1, C170.1, R101.2, R105.1, TR4.5
unnamed: C175.1, C178.1, R110.2, R112.1
unnamed: C176.1, C178.2, R111.2, R114.1
unnamed: R86.2, TR3.4
unnamed: R87.2, TR3.6
unnamed: R96.2, R97.1, R99.1, U12.1
unnamed: R99.2, R103.1, U14.3 (+)
unnamed: R97.2, R106.1, U13.4 (-)
unnamed: R106.2, R110.1, U13.1
unnamed: R107.2, R111.1, U14.1
unnamed: R108.1, TR4.4
unnamed: R109.1, TR4.6
PD: J6.2, U11.40 (PD)
REFN_B: R82.2
REFP_B: R85.2
TO_INPUT_DIFF_B: C166.1, R100.1, U12.3 (+)
VS+B: C162.1, C163.1, R101.1
~OE: J5.2, U11.39 (~OE)

Notes on the sheet:
Converte o sinal de entrada de modo comum para diferencial usando um transformador de RF conforme o kit de avaliação
Converte o sinal de entrada de modo comum para diferenicial usando AmpOp como indicado no datasheet
