fabriciomicheldenes/Momea/MomeaProbe12/Fonte.kicad_sch

## KiCad design MomeaProbe12/Fonte.kicad_sch (2024-12-18)

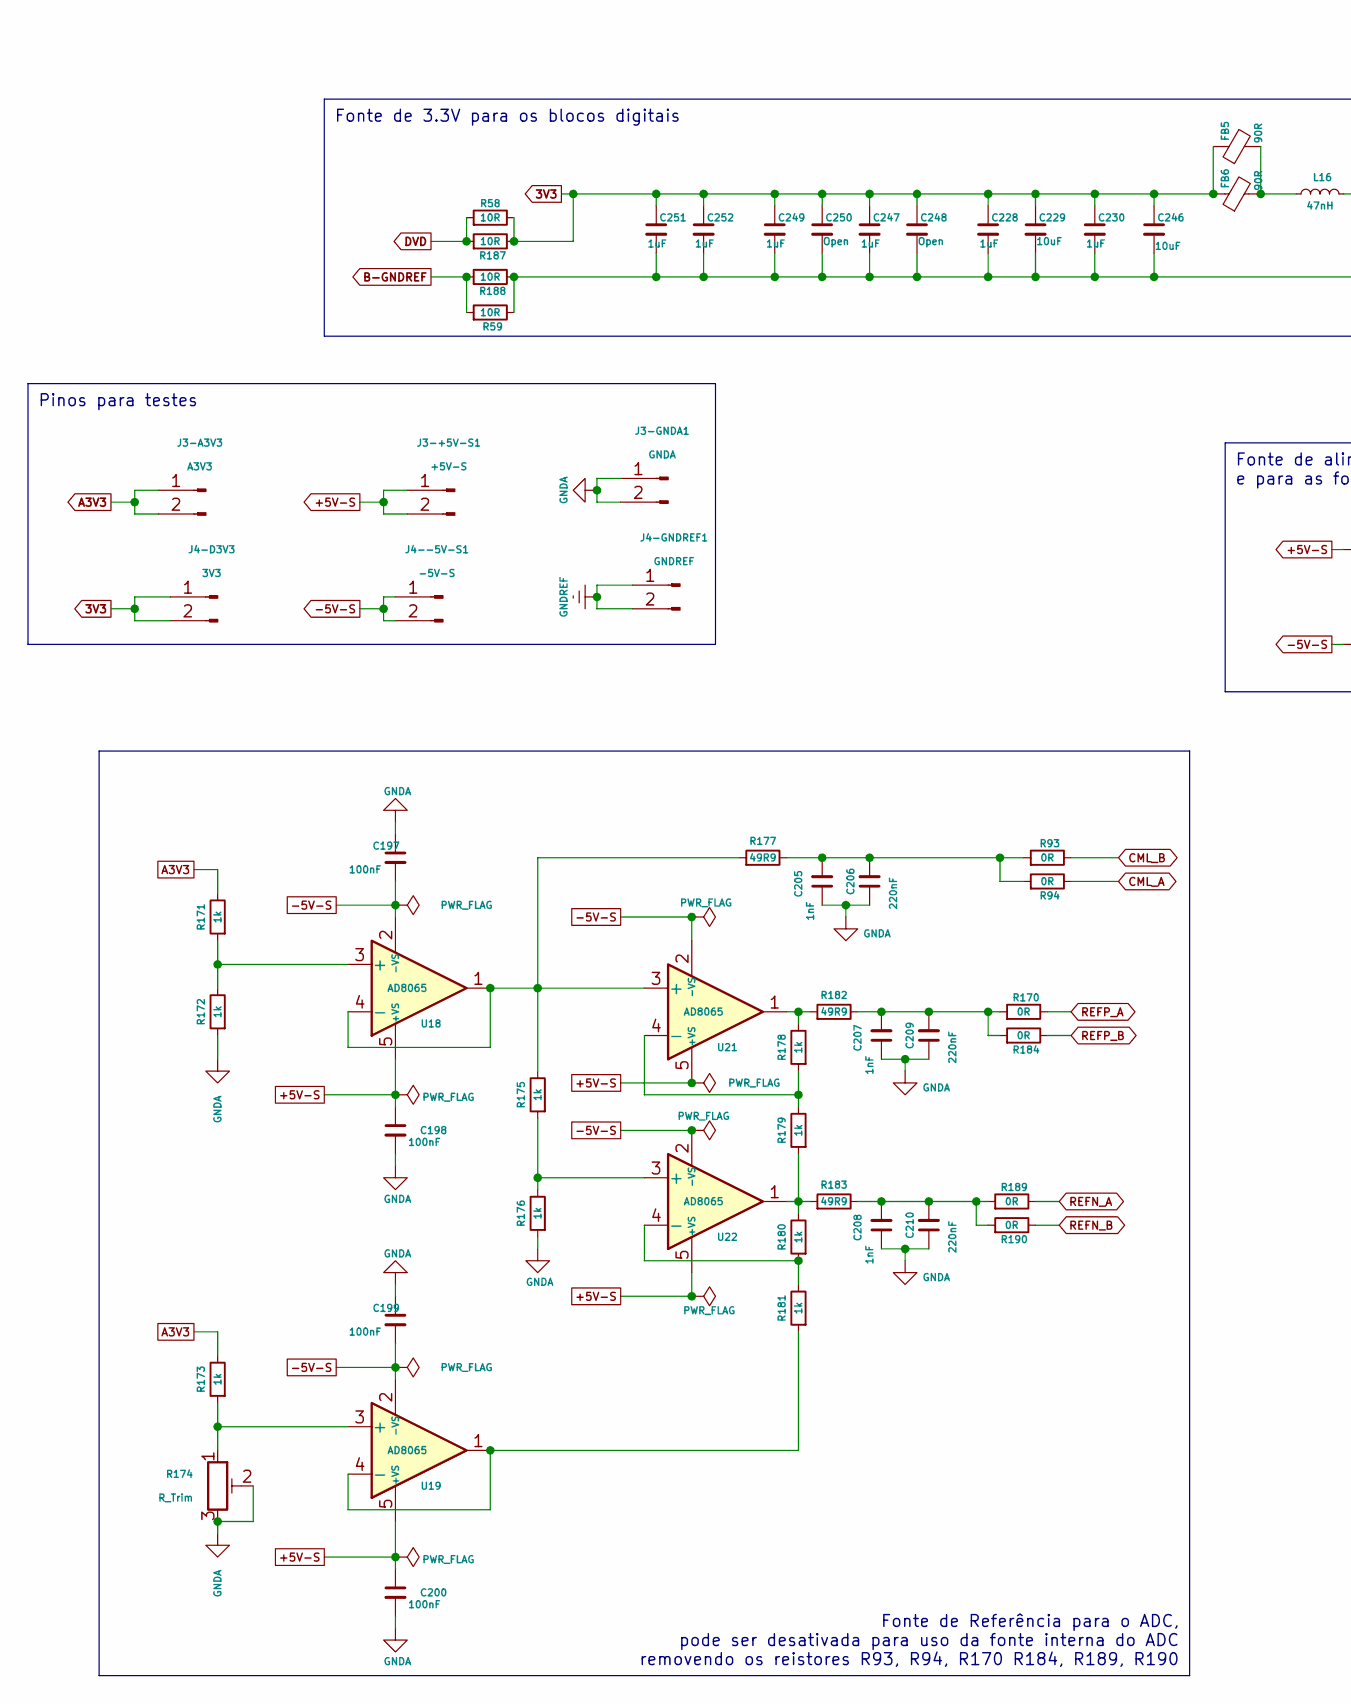
[picture p8: schematic Fonte.kicad_sch, part in row 1, column 1]

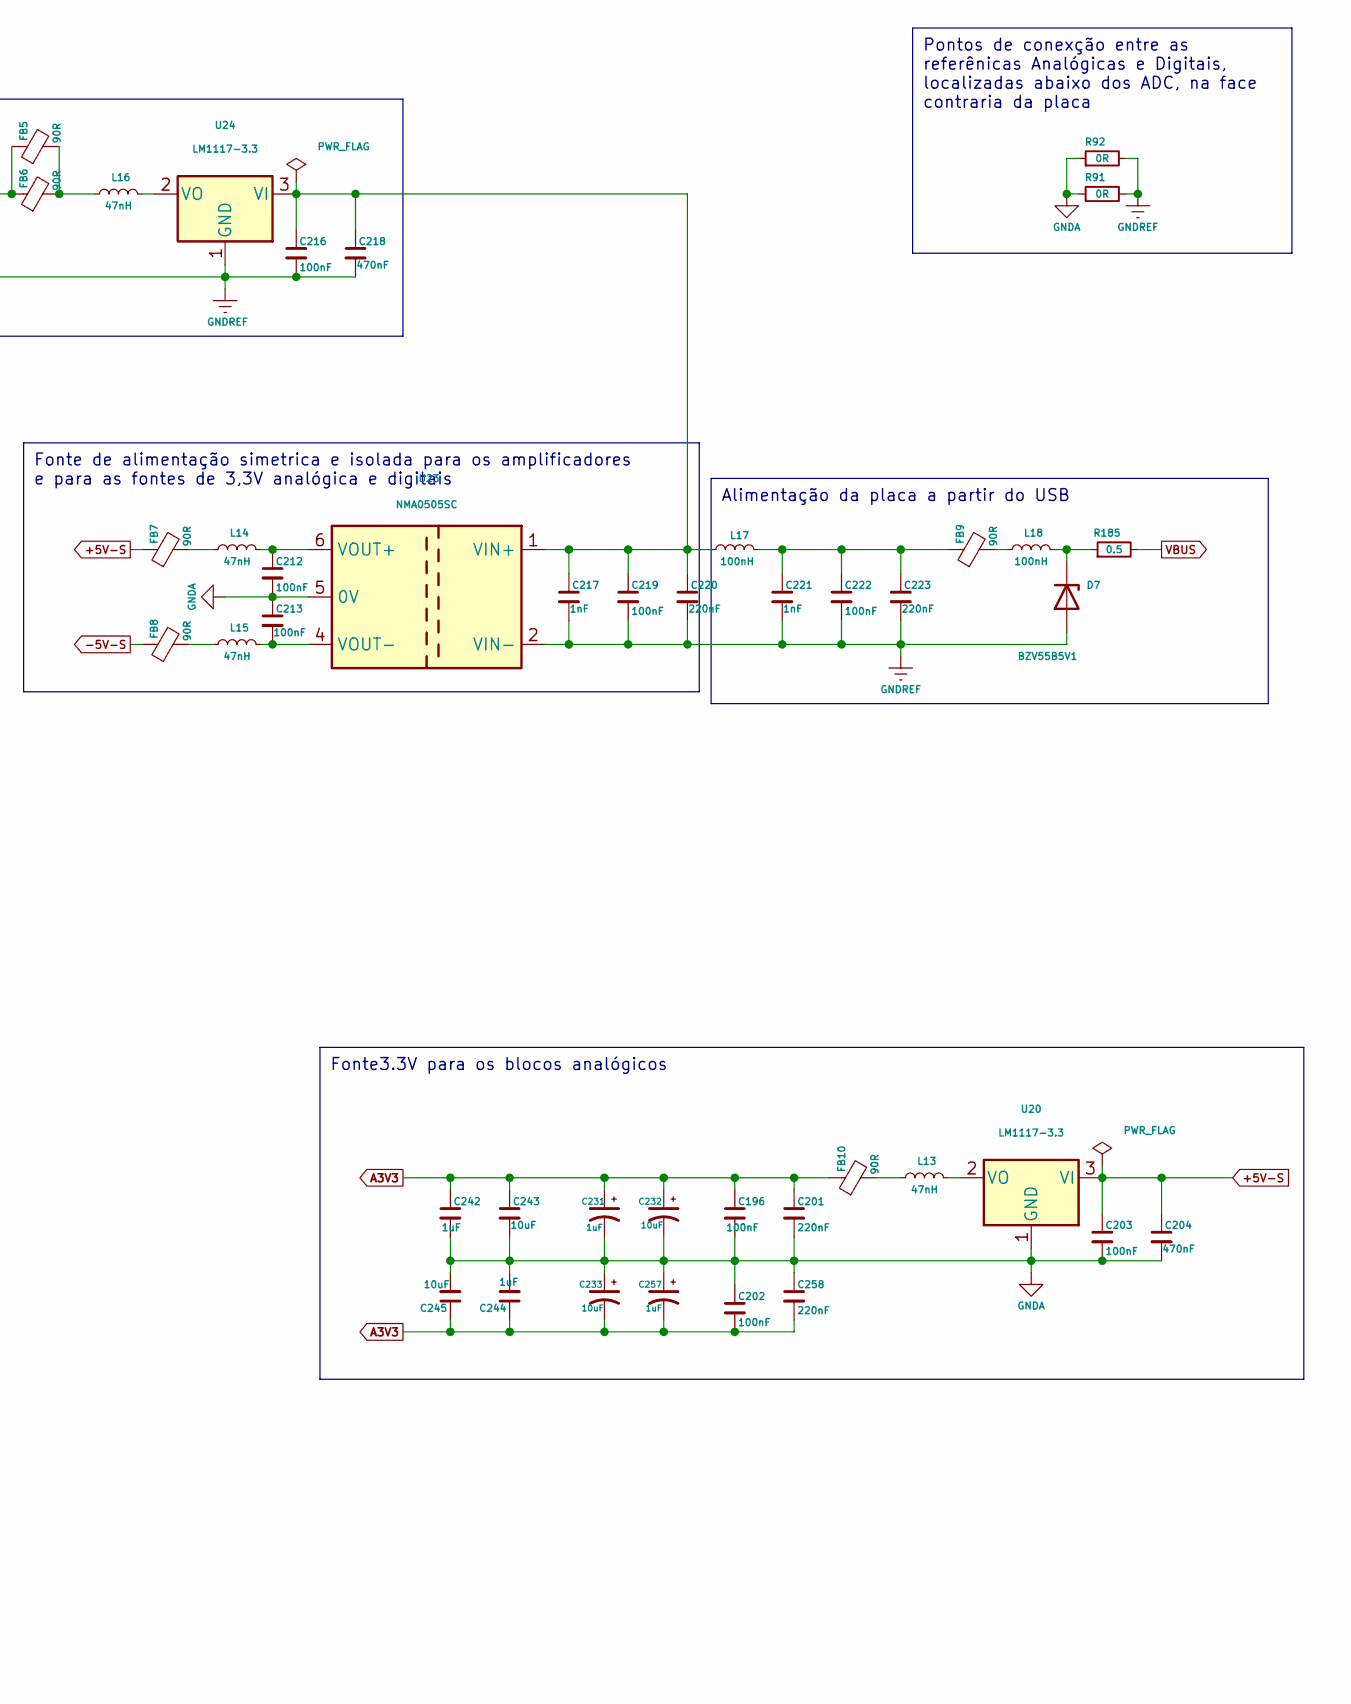
[picture p9: schematic Fonte.kicad_sch, part in row 1, column 2]

Parts:
C196, C197, C198, C199, C200, C202, C203, C212, C213, C216, C219, C222: 100nF; C_0603_1608Metric
C201, C258: 220nF; C_0603_1608Metric
C204, C218: 470nF; C_0805_2012Metric
C205, C207, C208, C217, C221: 1nF; C_0603_1608Metric
C206, C209, C210, C220, C223: 220nF; C_0805_2012Metric
C228, C230, C242, C244, C251, C252: 1uF; C_1206_3216Metric
C229, C243, C245, C246: 10uF; C_1206_3216Metric
C231, C257: 1uF; CP_Elec_4x3.9
C232, C233: 10uF; CP_Elec_4x3.9
C247, C249: 1uF; C_0805_2012Metric
C248, C250: Open; C_0805_2012Metric
D7: BZV55B5V1; D_MiniMELF
FB5, FB6, FB7, FB8, FB9, FB10: 90R; L_1206_3216Metric
J3-+5V-S1: +5V-S; PinHeader_1x02_P2.54mm_Vertical
J3-A3V3: A3V3; PinHeader_1x02_P2.54mm_Vertical
J3-GNDA1: GNDA; PinHeader_1x02_P2.54mm_Vertical
J4--5V-S1: -5V-S; PinHeader_1x02_P2.54mm_Vertical
J4-D3V3: 3V3; PinHeader_1x02_P2.54mm_Vertical
J4-GNDREF1: GNDREF; PinHeader_1x02_P2.54mm_Vertical
L13, L14, L15, L16: 47nH; L_0805_2012Metric
L17, L18: 100nH; L_0805_2012Metric
R58, R59, R187, R188: 10R; R_1206_3216Metric
R91, R92: 0R; R_0402_1005Metric
R93, R94, R170, R184, R189, R190: 0R; R_0603_1608Metric
R171, R172, R173, R175, R176, R178, R179, R180, R181: 1k; R_0603_1608Metric
R174: R_Trim; Potentiometer_Bourns_3296W_Vertical
R177, R182, R183: 49R9; R_0603_1608Metric
R185: 0.5; R_1206_3216Metric
U18, U19, U21, U22: AD8065; AD8065ARTZ-R2
U20, U24: LM1117-3.3; SOT-223-3_TabPin2
U23: NMA0505SC; Converter_DCDC_Murata_NMAxxxxSC_THT

Connections:
3V3: C228.1, C229.1, C230.1, C246.1, C247.1, C248.1, C249.1, C250.1, C251.1, C252.1, FB5.1, FB6.1, J4-D3V3.1, J4-D3V3.2, R58.2, R187.2
+5V-S: C198.1, C200.1, C203.1, C204.1, FB7.1, J3-+5V-S1.1, J3-+5V-S1.2, U18.5 (+VS), U19.5 (+VS), U20.3 (VI), U21.5 (+VS), U22.5 (+VS)
-5V-S: C197.2, C199.2, FB8.1, J4--5V-S1.1, J4--5V-S1.2, U18.2 (-VS), U19.2 (-VS), U21.2 (-VS), U22.2 (-VS)
A3V3: C196.1, C201.1, C202.2, C231.1, C232.1, C233.2, C242.1, C243.1, C244.1, C245.1, C257.2, C258.2, FB10.1, J3-A3V3.1, J3-A3V3.2, R171.2, R173.2
B-GNDREF: R59.1, R188.1
CML_A: R94.2
CML_B: R93.2
DVD: R58.1, R187.1
GNDA: C196.2, C197.1, C198.2, C199.1, C200.2, C201.2, C202.1, C203.2, C204.2, C205.1, C206.1, C207.1, C208.1, C209.1, C210.1, C212.2, C213.1, C231.2, C232.2, C233.1, C242.2, C243.2, C244.2, C245.2, C257.1, C258.1, J3-GNDA1.1, J3-GNDA1.2, R91.1, R92.1, R172.1, R174.2, R174.3, R176.1, U20.1 (GND), U23.5 (0V)
GNDREF: C216.2, C217.2, C218.2, C219.2, C220.2, C221.2, C222.2, C223.2, C228.2, C229.2, C230.2, C246.2, C247.2, C248.2, C249.2, C250.2, C251.2, C252.2, D7.2 (A), J4-GNDREF1.1, J4-GNDREF1.2, R59.2, R91.2, R92.2, R188.2, U23.2 (VIN-), U24.1 (GND)
unnamed: C205.2, C206.2, R93.1, R94.1, R177.2
unnamed: C207.2, C209.2, R170.1, R182.2, R184.1
unnamed: C208.2, C210.2, R183.2, R189.1, R190.1
unnamed: C212.1, L14.2, U23.6 (VOUT+)
unnamed: C213.2, L15.2, U23.4 (VOUT-)
unnamed: C216.1, C217.1, C218.1, C219.1, C220.1, L17.1, U23.1 (VIN+), U24.3 (VI)
unnamed: C221.1, C222.1, C223.1, FB9.1, L17.2
unnamed: D7.1 (K), L18.2, R185.1
unnamed: FB5.2, FB6.2, L16.1
unnamed: FB7.2, L14.1
unnamed: FB8.2, L15.1
unnamed: FB9.2, L18.1
unnamed: FB10.2, L13.1
unnamed: L13.2, U20.2 (VO)
unnamed: L16.2, U24.2 (VO)
unnamed: R171.1, R172.2, U18.3 (+)
unnamed: R173.1, R174.1, U19.3 (+)
unnamed: R175.1, R176.2, U22.3 (+)
unnamed: R175.2, R177.1, U18.1, U18.4 (-), U21.3 (+)
unnamed: R178.1, R179.2, U21.4 (-)
unnamed: R178.2, R182.1, U21.1
unnamed: R179.1, R180.2, R183.1, U22.1
unnamed: R180.1, R181.2, U22.4 (-)
unnamed: R181.1, U19.1, U19.4 (-)
REFN_A: R189.2
REFN_B: R190.2
REFP_A: R170.2
REFP_B: R184.2
VBUS: R185.2

Notes on the sheet:
Fonte de alimentação simetrica e isolada para os amplificadores e para as fontes de 3,3V analógica e digitais
Pinos para testes
Alimentação da placa a partir do USB
Pontos de conexção entre as referênicas Analógicas e Digitais, localizadas abaixo dos ADC, na face contraria da placa
Fonte3.3V para os blocos analógicos
Fonte de 3.3V para os blocos digitais
Fonte de Referência para o ADC, pode ser desativada para uso da fonte interna do ADC removendo os reistores R93, R94, R170 R184, R189, R190
