fabriciomicheldenes/Momea/MomeaProbe12/Processamento.kicad_sch

## KiCad design MomeaProbe12/Processamento.kicad_sch (2024-12-18)

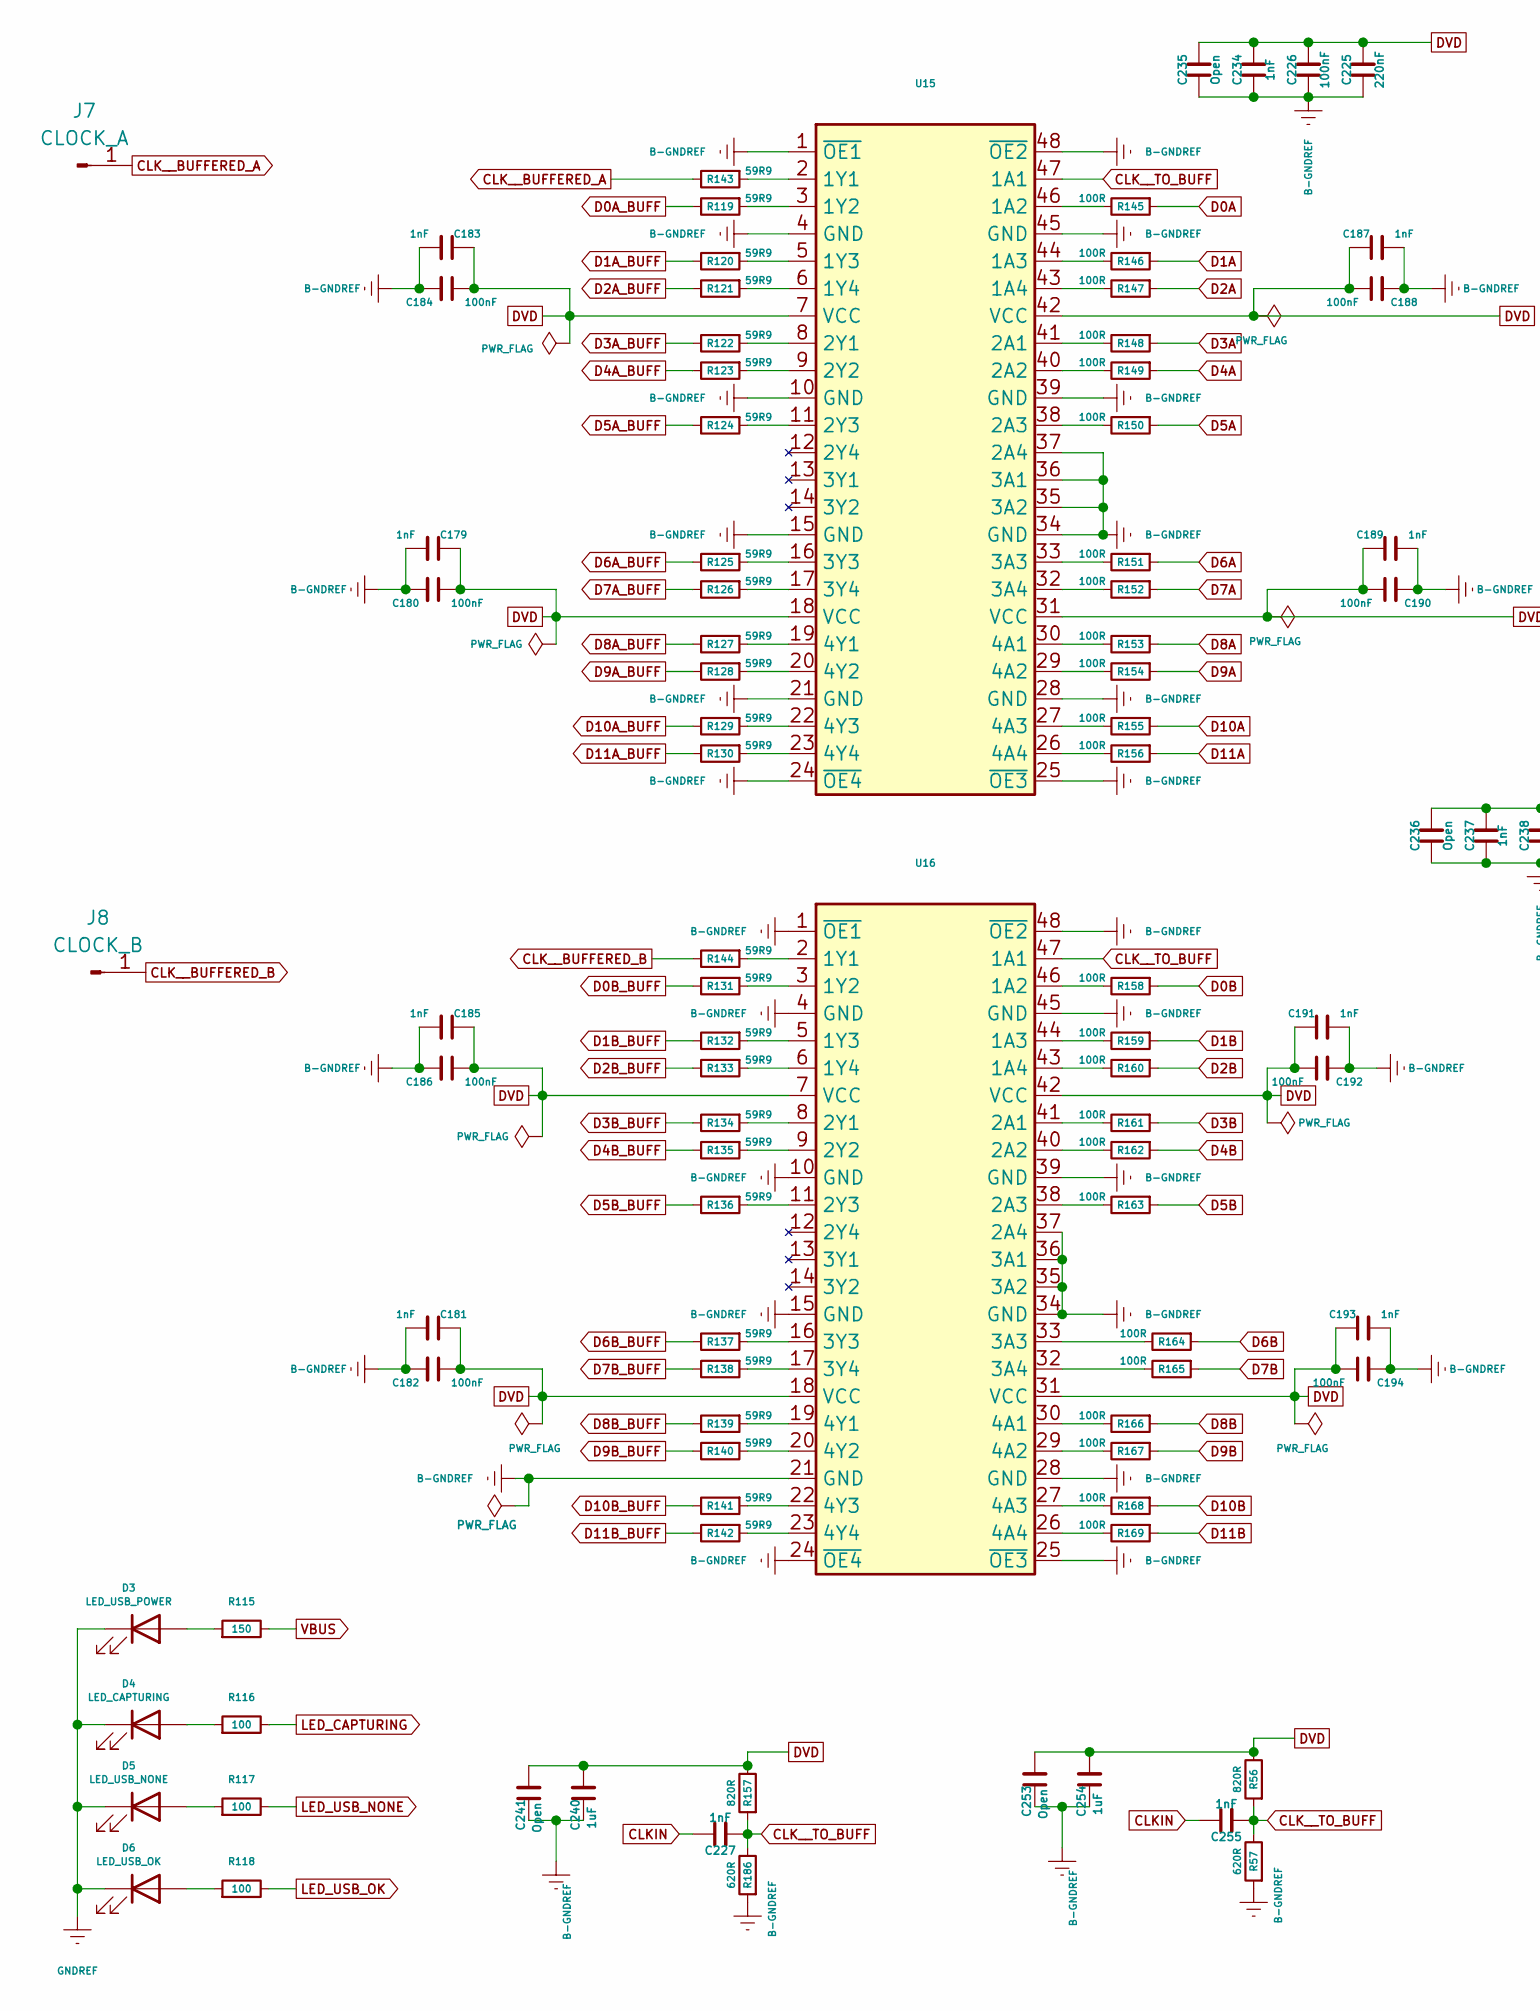
[picture p10: schematic Processamento.kicad_sch, part in row 1, column 1]

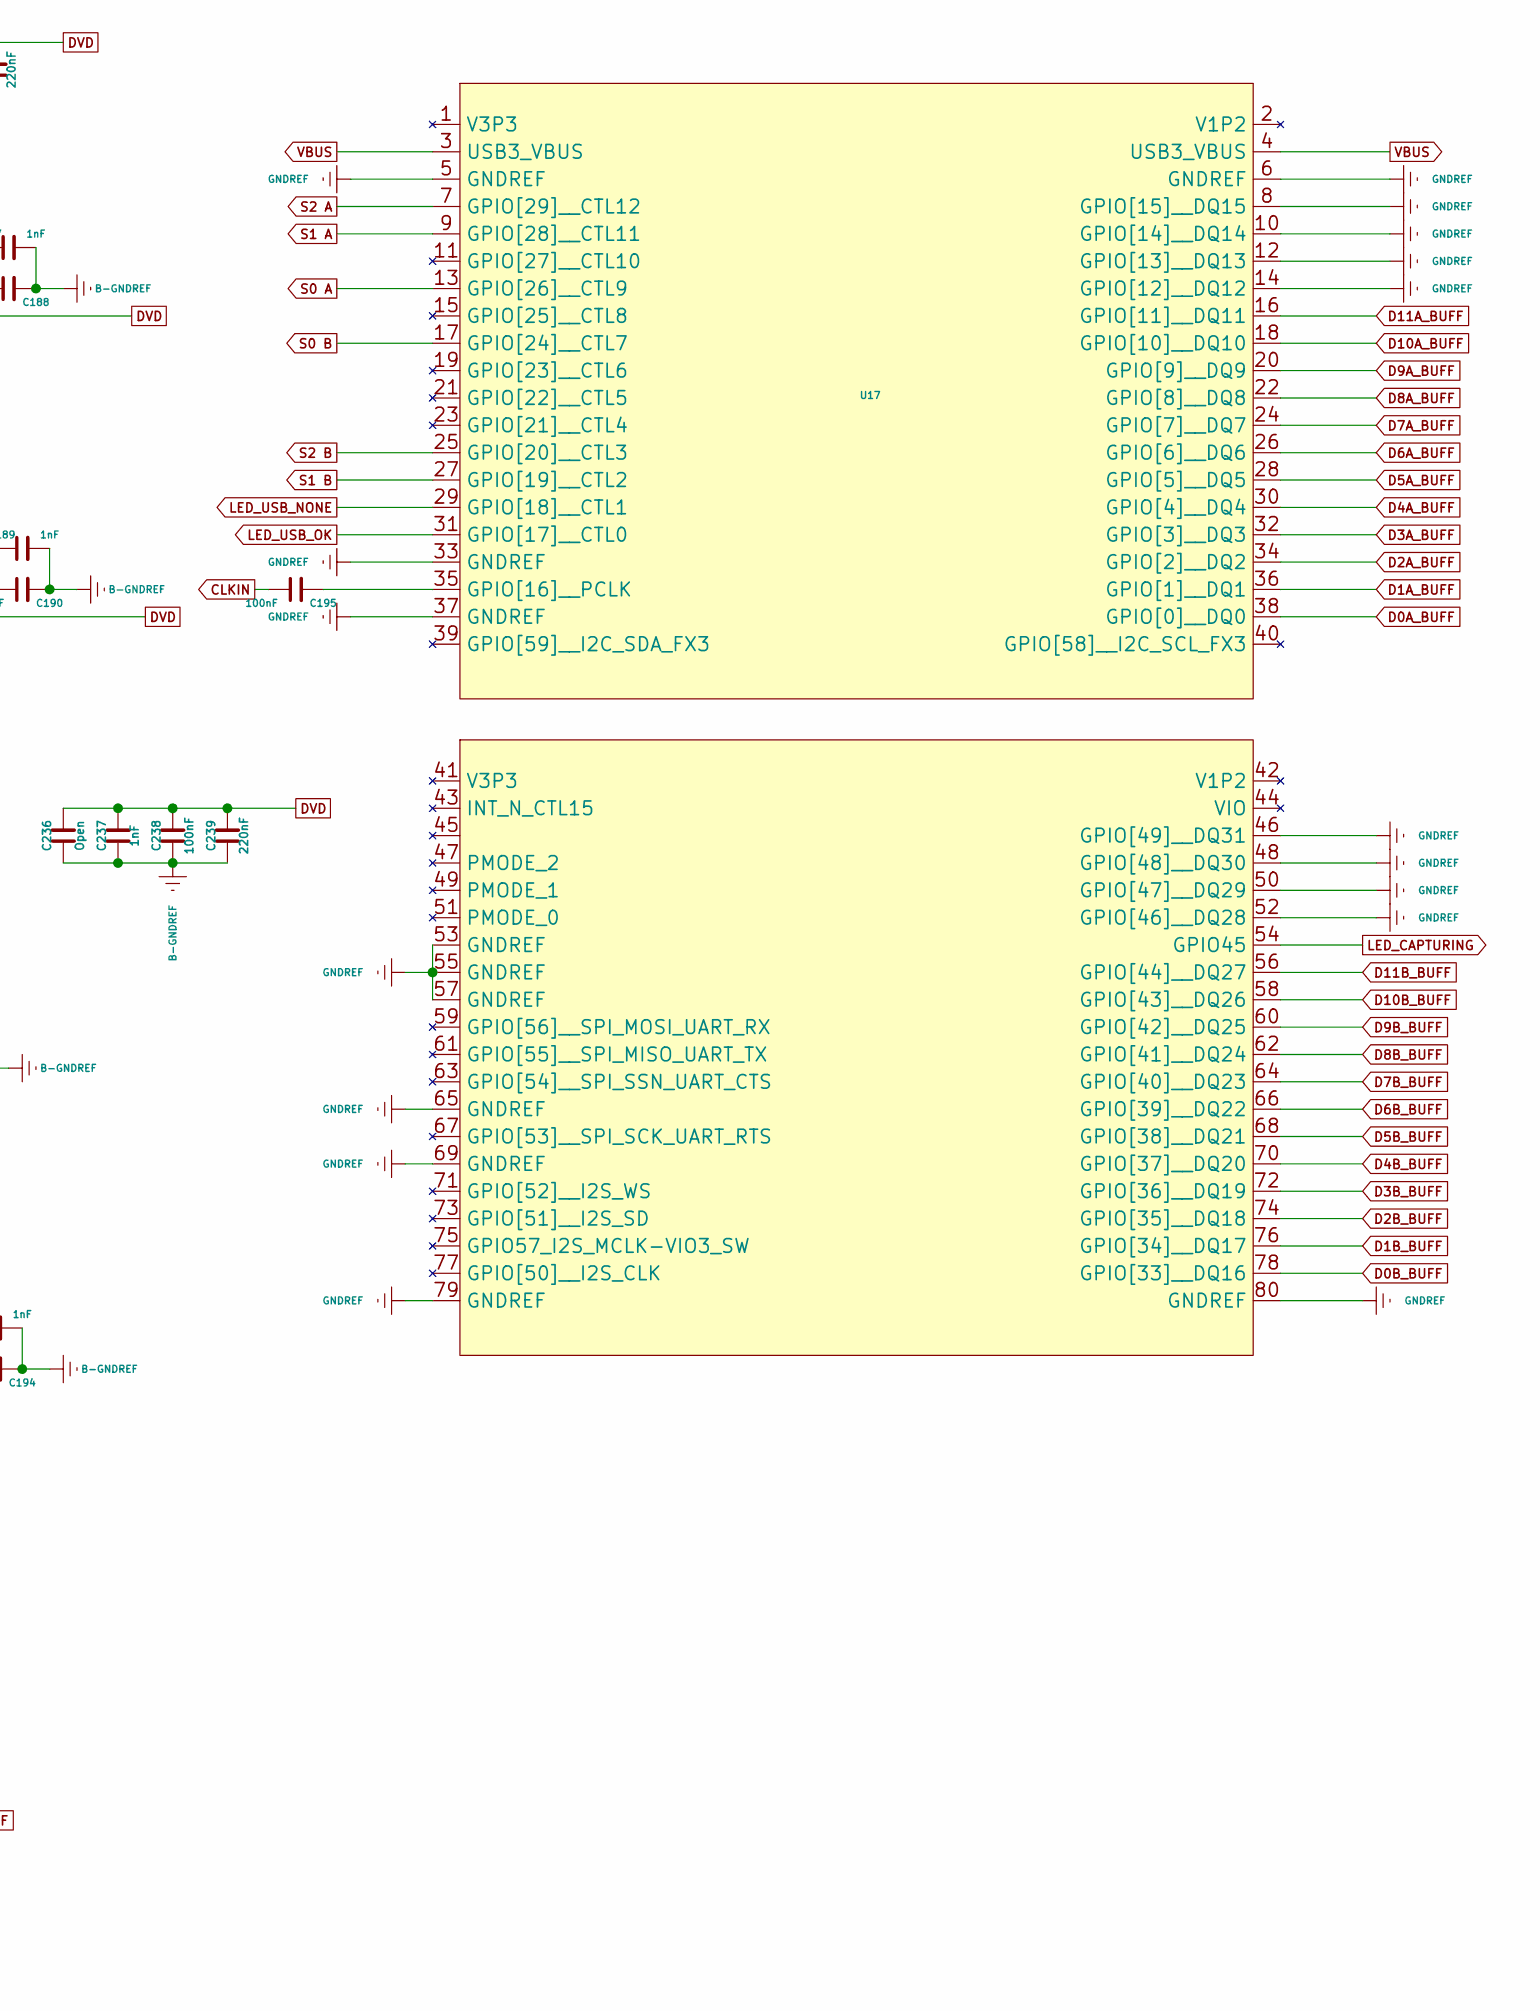
[picture p11: schematic Processamento.kicad_sch, part in row 1, column 2]

Parts:
C179, C181, C183, C185, C187, C189, C191, C193, C234, C237: 1nF; C_0603_1608Metric
C180, C182, C184, C186, C188, C190, C192, C194, C195, C226, C238: 100nF; C_0603_1608Metric
C225, C239: 220nF; C_0603_1608Metric
C227, C255: 1nF; C_0402_1005Metric
C235, C236, C241, C253: Open; C_0603_1608Metric
C240, C254: 1uF; C_0805_2012Metric
D3: LED_USB_POWER; LED_0805_2012Metric
D4: LED_CAPTURING; LED_0805_2012Metric
D5: LED_USB_NONE; LED_0805_2012Metric
D6: LED_USB_OK; LED_0805_2012Metric
J7: CLOCK_A; PinHeader_1x01_P1.00mm_Vertical
J8: CLOCK_B; PinHeader_1x01_P1.00mm_Vertical
R56, R157: 820R; R_0805_2012Metric
R57, R186: 620R; R_0805_2012Metric
R115: 150; R_0603_1608Metric
R116, R117, R118: 100; R_0603_1608Metric
R119, R120, R121, R122, R123, R124, R125, R126, R127, R128, R129, R130, R131, R132, R133, R134, R135, R136, R137, R138, R139, R140, R141, R142, R143, R144: 59R9; R_0603_1608Metric
R145, R146, R147, R148, R149, R150, R151, R152, R153, R154, R155, R156, R158, R159, R160, R161, R162, R163, R164, R165, R166, R167, R168, R169: 100R; R_0603_1608Metric
U15, U16: TSSOP-48_6.1x12.5mm_P0.5mm
U17: FX3_USB3.0_KIT

Connections:
B-GNDREF: C179.2, C180.2, C181.2, C182.2, C183.2, C184.2, C185.2, C186.2, C187.2, C188.2, C189.2, C190.2, C191.2, C192.2, C193.2, C194.2, C225.1, C226.1, C234.1, C235.1, C236.1, C237.1, C238.1, C239.1, C240.1, C241.1, C253.1, C254.1, R57.1, R186.1, U15.1 (~OE1), U15.4 (GND), U15.10 (GND), U15.15 (GND), U15.21 (GND), U15.24 (~OE4), U15.25 (~OE3), U15.28 (GND), U15.34 (GND), U15.35 (3A2), U15.36 (3A1), U15.37 (2A4), U15.39 (GND), U15.45 (GND), U15.48 (~OE2), U16.1 (~OE1), U16.4 (GND), U16.10 (GND), U16.15 (GND), U16.21 (GND), U16.24 (~OE4), U16.25 (~OE3), U16.28 (GND), U16.34 (GND), U16.35 (3A2), U16.36 (3A1), U16.37 (2A4), U16.39 (GND), U16.45 (GND), U16.48 (~OE2)
CLKIN: C195.1, C227.1, C255.1
CLK__BUFFERED_A: J7.1, R143.2
CLK__BUFFERED_B: J8.1, R144.2
CLK__TO_BUFF: C227.2, C255.2, R56.1, R57.2, R157.1, R186.2, U15.47 (1A1), U16.47 (1A1)
D0A: R145.1
D0A_BUFF: R119.2, U17.38 (GPIO[0]__DQ0)
D0B: R158.1
D0B_BUFF: R131.2, U17.78 (GPIO[33]__DQ16)
D1A: R146.1
D1A_BUFF: R120.2, U17.36 (GPIO[1]__DQ1)
D1B: R159.1
D1B_BUFF: R132.2, U17.76 (GPIO[34]__DQ17)
D2A: R147.1
D2A_BUFF: R121.2, U17.34 (GPIO[2]__DQ2)
D2B: R160.1
D2B_BUFF: R133.2, U17.74 (GPIO[35]__DQ18)
D3A: R148.1
D3A_BUFF: R122.2, U17.32 (GPIO[3]__DQ3)
D3B: R161.1
D3B_BUFF: R134.2, U17.72 (GPIO[36]__DQ19)
D4A: R149.1
D4A_BUFF: R123.2, U17.30 (GPIO[4]__DQ4)
D4B: R162.1
D4B_BUFF: R135.2, U17.70 (GPIO[37]__DQ20)
D5A: R150.1
D5A_BUFF: R124.2, U17.28 (GPIO[5]__DQ5)
D5B: R163.1
D5B_BUFF: R136.2, U17.68 (GPIO[38]__DQ21)
D6A: R151.1
D6A_BUFF: R125.2, U17.26 (GPIO[6]__DQ6)
D6B: R164.1
D6B_BUFF: R137.2, U17.66 (GPIO[39]__DQ22)
D7A: R152.1
D7A_BUFF: R126.2, U17.24 (GPIO[7]__DQ7)
D7B: R165.1
D7B_BUFF: R138.2, U17.64 (GPIO[40]__DQ23)
D8A: R153.1
D8A_BUFF: R127.2, U17.22 (GPIO[8]__DQ8)
D8B: R166.1
D8B_BUFF: R139.2, U17.62 (GPIO[41]__DQ24)
D9A: R154.1
D9A_BUFF: R128.2, U17.20 (GPIO[9]__DQ9)
D9B: R167.1
D9B_BUFF: R140.2, U17.60 (GPIO[42]__DQ25)
D10A: R155.1
D10A_BUFF: R129.2, U17.18 (GPIO[10]__DQ10)
D10B: R168.1
D10B_BUFF: R141.2, U17.58 (GPIO[43]__DQ26)
D11A: R156.1
D11A_BUFF: R130.2, U17.16 (GPIO[11]__DQ11)
D11B: R169.1
D11B_BUFF: R142.2, U17.56 (GPIO[44]__DQ27)
DVD: C179.1, C180.1, C181.1, C182.1, C183.1, C184.1, C185.1, C186.1, C187.1, C188.1, C189.1, C190.1, C191.1, C192.1, C193.1, C194.1, C225.2, C226.2, C234.2, C235.2, C236.2, C237.2, C238.2, C239.2, C240.2, C241.2, C253.2, C254.2, R56.2, R157.2, U15.7 (VCC), U15.18 (VCC), U15.31 (VCC), U15.42 (VCC), U16.7 (VCC), U16.18 (VCC), U16.31 (VCC), U16.42 (VCC)
GNDREF: D3.1 (K), D4.1 (K), D5.1 (K), D6.1 (K), U17.5 (GNDREF), U17.6 (GNDREF), U17.8 (GPIO[15]__DQ15), U17.10 (GPIO[14]__DQ14), U17.12 (GPIO[13]__DQ13), U17.14 (GPIO[12]__DQ12), U17.33 (GNDREF), U17.37 (GNDREF), U17.46 (GPIO[49]__DQ31), U17.48 (GPIO[48]__DQ30), U17.50 (GPIO[47]__DQ29), U17.52 (GPIO[46]__DQ28), U17.53 (GNDREF), U17.55 (GNDREF), U17.57 (GNDREF), U17.65 (GNDREF), U17.69 (GNDREF), U17.79 (GNDREF), U17.80 (GNDREF)
LED_CAPTURING: R116.2, U17.54 (GPIO45)
LED_USB_NONE: R117.2, U17.29 (GPIO[18]__CTL1)
LED_USB_OK: R118.2, U17.31 (GPIO[17]__CTL0)
unnamed: C195.2, U17.35 (GPIO[16]__PCLK)
unnamed: D3.2 (A), R115.1
unnamed: D4.2 (A), R116.1
unnamed: D5.2 (A), R117.1
unnamed: D6.2 (A), R118.1
unnamed: R119.1, U15.3 (1Y2)
unnamed: R120.1, U15.5 (1Y3)
unnamed: R121.1, U15.6 (1Y4)
unnamed: R122.1, U15.8 (2Y1)
unnamed: R123.1, U15.9 (2Y2)
unnamed: R124.1, U15.11 (2Y3)
unnamed: R125.1, U15.16 (3Y3)
unnamed: R126.1, U15.17 (3Y4)
unnamed: R127.1, U15.19 (4Y1)
unnamed: R128.1, U15.20 (4Y2)
unnamed: R129.1, U15.22 (4Y3)
unnamed: R130.1, U15.23 (4Y4)
unnamed: R131.1, U16.3 (1Y2)
unnamed: R132.1, U16.5 (1Y3)
unnamed: R133.1, U16.6 (1Y4)
unnamed: R134.1, U16.8 (2Y1)
unnamed: R135.1, U16.9 (2Y2)
unnamed: R136.1, U16.11 (2Y3)
unnamed: R137.1, U16.16 (3Y3)
unnamed: R138.1, U16.17 (3Y4)
unnamed: R139.1, U16.19 (4Y1)
unnamed: R140.1, U16.20 (4Y2)
unnamed: R141.1, U16.22 (4Y3)
unnamed: R142.1, U16.23 (4Y4)
unnamed: R143.1, U15.2 (1Y1)
unnamed: R144.1, U16.2 (1Y1)
unnamed: R145.2, U15.46 (1A2)
unnamed: R146.2, U15.44 (1A3)
unnamed: R147.2, U15.43 (1A4)
unnamed: R148.2, U15.41 (2A1)
unnamed: R149.2, U15.40 (2A2)
unnamed: R150.2, U15.38 (2A3)
unnamed: R151.2, U15.33 (3A3)
unnamed: R152.2, U15.32 (3A4)
unnamed: R153.2, U15.30 (4A1)
unnamed: R154.2, U15.29 (4A2)
unnamed: R155.2, U15.27 (4A3)
unnamed: R156.2, U15.26 (4A4)
unnamed: R158.2, U16.46 (1A2)
unnamed: R159.2, U16.44 (1A3)
unnamed: R160.2, U16.43 (1A4)
unnamed: R161.2, U16.41 (2A1)
unnamed: R162.2, U16.40 (2A2)
unnamed: R163.2, U16.38 (2A3)
unnamed: R164.2, U16.33 (3A3)
unnamed: R165.2, U16.32 (3A4)
unnamed: R166.2, U16.30 (4A1)
unnamed: R167.2, U16.29 (4A2)
unnamed: R168.2, U16.27 (4A3)
unnamed: R169.2, U16.26 (4A4)
S0 A: U17.13 (GPIO[26]__CTL9)
S0 B: U17.17 (GPIO[24]__CTL7)
S1 A: U17.9 (GPIO[28]__CTL11)
S1 B: U17.27 (GPIO[19]__CTL2)
S2 A: U17.7 (GPIO[29]__CTL12)
S2 B: U17.25 (GPIO[20]__CTL3)
VBUS: R115.2, U17.3 (USB3_VBUS), U17.4 (USB3_VBUS)
