fabriciomicheldenes/Momea/Firmware/USBBulkSourceSinkLED_Separado/cyfxbulksrcsink.c

/*
 ## Cypress USB 3.0 Platform source file (cyfxbulksrcsink.c)
 ## ===========================
 ##
 ##  Copyright Cypress Semiconductor Corporation, 2010-2011,
 ##  All Rights Reserved
 ##  UNPUBLISHED, LICENSED SOFTWARE.
 ##
 ##  CONFIDENTIAL AND PROPRIETARY INFORMATION
 ##  WHICH IS THE PROPERTY OF CYPRESS.
 ##
 ##  Use of this file is governed
 ##  by the license agreement included in the file
 ##
 ##     <install>/license/license.txt
 ##
 ##  where <install> is the Cypress software
 ##  installation root directory path.
 ##
 ## ===========================
*/

/* This file illustrates the bulk source sink LED application example using the DMA MANUAL_IN
   and DMA MANUAL_OUT mode */

/*
   This example illustrates on how to configure the GPIO as an output and drive the LED.
   The LED will blink at 50ms rate if the FX3 DVK is connected to a SuperSpeed USB port. The LED
   will always turn ON if connected to a HighSpeed USB port and will be OFF of connected to a
   FullSpeed USB port. The user can also change the LED on-time and off-time by using the vendor
   command (0xAA). Refer to the FX3 DVK User-Guide on how to change the blinking rate of the LED
   using the vendor request.

   This example also illustrates USB endpoint data source and data sink mechanism. The example
   comprises of vendor class USB enumeration descriptors with 2 bulk endpoints. A bulk OUT
   endpoint acts as the producer of data and acts as the sink to the host. A bulk IN endpoint
   acts as the consumer of data and acts as the source to the host.

   The data source and sink is achieved with the help of a DMA MANUAL IN channel and a DMA
   MANUAL OUT channel. A DMA MANUAL IN channel is created between the producer USB bulk
   endpoint and the CPU. A DMA MANUAL OUT channel is created between the CPU and the consumer
   USB bulk endpoint. Data is received in the IN channel DMA buffer from the host through the
   producer endpoint. CPU is signaled of the data reception using DMA callbacks. The CPU
   discards this buffer. This leads to the sink mechanism. A constant pattern data is loaded
   onto the OUT Channel DMA buffer whenever the buffer is available. CPU issues commit of
   the DMA data transfer to the consumer endpoint which then gets transferred to the host.
   This leads to a constant source mechanism.

   The DMA buffer size is defined based on the USB speed. 64 for full speed, 512 for high speed
   and 1024 for super speed. CY_FX_BULKSRCSINK_DMA_BUF_COUNT in the header file defines the
   number of DMA buffers.
   
   For performance optimizations refer the readme.txt
 */
#include "ThreadEntry.h"
#include "cyfxbulksrcsink.h"
#include "DMACallback.h"


CyU3PDmaChannel glChHandleBulkSink;      /* DMA MANUAL_IN channel handle.          */
CyU3PDmaChannel glChHandleBulkSrc;       /* DMA MANUAL_OUT channel handle.         */

CyBool_t glIsApplnActive = CyFalse;      /* Whether the source sink application is active or not. */
CyBool_t glDataTransStarted = CyFalse;   /* Whether DMA transfer has been started after enumeration. */
CyBool_t StandbyModeEnable  = CyFalse;   /* Whether standby mode entry is enabled. */
CyBool_t TriggerStandbyMode = CyFalse;   /* Request to initiate standby entry. */
CyBool_t glForceLinkU2      = CyFalse;   /* Whether the device should try to initiate U2 mode. */

volatile uint32_t glEp0StatCount = 0;           /* Number of EP0 status events received. */
uint16_t on_time = 0, off_time = 0;

/* Buffer used for USB event logs. */
uint8_t *gl_UsbLogBuffer = NULL;

/**
 * Main function
 */
int main (void)
{
    CyU3PIoMatrixConfig_t io_cfg;
    CyU3PReturnStatus_t status = CY_U3P_SUCCESS;

    /* Initialize the device */
    CyU3PSysClockConfig_t clockConfig;
    clockConfig.setSysClk400  = CyTrue;
    clockConfig.cpuClkDiv     = 2;
    clockConfig.dmaClkDiv     = 2;
    clockConfig.mmioClkDiv    = 2;
    clockConfig.useStandbyClk = CyFalse;
    clockConfig.clkSrc         = CY_U3P_SYS_CLK;
    status = CyU3PDeviceInit (&clockConfig);
    if (status != CY_U3P_SUCCESS)
    {
        goto handle_fatal_error;
    }

    /* Initialize the caches. Enable Instruction Cache and Disable Data caches. */
    status = CyU3PDeviceCacheControl (CyTrue, CyFalse, CyFalse);
    if (status != CY_U3P_SUCCESS)
    {
        goto handle_fatal_error;
    }

    /* Configure the IO matrix for the device. On the FX3 DVK board, the COM port 
     * is connected to the IO(53:56). This means that either DQ32 mode should be
     * selected or lppMode should be set to UART_ONLY. Here we are choosing
     * UART_ONLY configuration. */
    io_cfg.isDQ32Bit = CyFalse;
    io_cfg.useUart   = CyTrue;
    io_cfg.useI2C    = CyFalse;
    io_cfg.useI2S    = CyFalse;
    io_cfg.useSpi    = CyFalse;
    io_cfg.lppMode   = CY_U3P_IO_MATRIX_LPP_UART_ONLY;

    io_cfg.gpioSimpleEn[0]  = 0;
    io_cfg.gpioSimpleEn[1]  = 0;						/* FX3_GPIO_TO_HIFLAG(FX3_GPIO_TEST_OUT) */
    io_cfg.gpioComplexEn[0] = 0;
    io_cfg.gpioComplexEn[1] = 0;
    status = CyU3PDeviceConfigureIOMatrix (&io_cfg);
    if (status != CY_U3P_SUCCESS)
    {
        goto handle_fatal_error;
    }

    /* This is a non returnable call for initializing the RTOS kernel */
    CyU3PKernelEntry ();

    /* Dummy return to make the compiler happy */
    return 0;

handle_fatal_error:

    /* Cannot recover from this error. */
    while (1);
}
