fabriciomicheldenes/Momea/Firmware/GpifToUsb_Clock_Separado/AppStart.c

/*
 * AppStart.c
 *
 *  Created on: 22/12/2024
 *      Author: FMichelD
 */

#include "AppStart.h"

/* This function starts the application. This is called
 * when a SET_CONF event is received from the USB host. The endpoints
 * are configured and the DMA pipe is setup in this function. */
void
CyFxApplnStart (
        void)
{
    uint16_t size = 0;
    CyU3PEpConfig_t epCfg;
    CyU3PDmaChannelConfig_t dmaCfg;
    CyU3PReturnStatus_t apiRetStatus = CY_U3P_SUCCESS;
    CyU3PUSBSpeed_t usbSpeed = CyU3PUsbGetSpeed();

    /* First identify the usb speed. Once that is identified,
     * create a DMA channel and start the transfer on this. */

    /* Based on the Bus Speed configure the endpoint packet size */
    switch (usbSpeed)
    {
    case CY_U3P_FULL_SPEED:
        size = 64;
        break;

    case CY_U3P_HIGH_SPEED:
        size = 512;
        break;

    case  CY_U3P_SUPER_SPEED:
        /* Disable USB link low power entry to optimize USB throughput. */
        CyU3PUsbLPMDisable();
        size = 1024;
        break;

    default:
        CyU3PDebugPrint (4, "Error! Invalid USB speed.\n");
        CyFxAppErrorHandler (CY_U3P_ERROR_FAILURE);
        break;
    }

    CyU3PMemSet ((uint8_t *)&epCfg, 0, sizeof (epCfg));
    epCfg.enable = CyTrue;
    epCfg.epType = CY_U3P_USB_EP_BULK;
    epCfg.burstLen = (usbSpeed == CY_U3P_SUPER_SPEED) ? (CY_FX_EP_BURST_LENGTH) : 1;
    epCfg.streams = 0;
    epCfg.pcktSize = size;

    /* Consumer endpoint configuration */
    apiRetStatus = CyU3PSetEpConfig (CY_FX_EP_CONSUMER, &epCfg);
    if (apiRetStatus != CY_U3P_SUCCESS)
    {
        CyU3PDebugPrint (4, "CyU3PSetEpConfig failed, Error code = %d\n", apiRetStatus);
        CyFxAppErrorHandler (apiRetStatus);
    }

    /*
       Configure the IN endpoint to allow combining data from multiple buffers into one burst.
       This can help achieve better performance in most cases.
     */
    CyU3PUsbEPSetBurstMode (CY_FX_EP_CONSUMER, CyTrue);

    /* Flush the endpoint memory */
    CyU3PUsbFlushEp(CY_FX_EP_CONSUMER);

    epCfg.burstLen = (usbSpeed == CY_U3P_SUPER_SPEED) ? 4 : 1;
    apiRetStatus = CyU3PSetEpConfig (CY_FX_EP_LOOP_OUT, &epCfg);
    if (apiRetStatus != CY_U3P_SUCCESS)
    {
        CyU3PDebugPrint (4, "CyU3PSetEpConfig failed, Error code = %d\n", apiRetStatus);
        CyFxAppErrorHandler (apiRetStatus);
    }

    apiRetStatus = CyU3PSetEpConfig (CY_FX_EP_LOOP_IN, &epCfg);
    if (apiRetStatus != CY_U3P_SUCCESS)
    {
        CyU3PDebugPrint (4, "CyU3PSetEpConfig failed, Error code = %d\n", apiRetStatus);
        CyFxAppErrorHandler (apiRetStatus);
    }

    CyU3PUsbRegisterEpEvtCallback (CyFxApplnEpCallback, 0x1B0, 0x04, 0x06);

    CyU3PUsbFlushEp (CY_FX_EP_LOOP_OUT);
    CyU3PUsbFlushEp (CY_FX_EP_LOOP_IN);

    /* Create a DMA AUTO channel for the GPIF to USB transfer. */
    CyU3PMemSet ((uint8_t *)&dmaCfg, 0, sizeof (dmaCfg));
    dmaCfg.size  = CY_FX_DMA_BUF_SIZE;
    dmaCfg.count = CY_FX_DMA_BUF_COUNT;
    dmaCfg.prodSckId = CY_FX_GPIF_PRODUCER_SOCKET;
    dmaCfg.consSckId = CY_FX_EP_CONSUMER_SOCKET;
    dmaCfg.dmaMode = CY_U3P_DMA_MODE_BYTE;
    dmaCfg.prodHeader = 0;
    dmaCfg.prodFooter = 0;
    dmaCfg.consHeader = 0;
    dmaCfg.prodAvailCount = 0;

#ifdef STREAMING_MANUAL
    dmaCfg.notification = CY_U3P_DMA_CB_CONS_SUSP | CY_U3P_DMA_CB_PROD_EVENT;
    dmaCfg.cb = GpifToUsbDmaCallback;
    apiRetStatus = CyU3PDmaChannelCreate (&glDmaChHandle, CY_U3P_DMA_TYPE_MANUAL, &dmaCfg);
#else
    dmaCfg.notification = CY_U3P_DMA_CB_CONS_SUSP;
    dmaCfg.cb = GpifToUsbDmaCallback;
    apiRetStatus = CyU3PDmaChannelCreate (&glDmaChHandle, CY_U3P_DMA_TYPE_AUTO, &dmaCfg);
#endif
    if (apiRetStatus != CY_U3P_SUCCESS)
    {
        CyU3PDebugPrint (4, "CyU3PDmaChannelCreate failed, Error code = %d\n", apiRetStatus);
        CyFxAppErrorHandler(apiRetStatus);
    }

    /* Set DMA Channel transfer size */
    apiRetStatus = CyU3PDmaChannelSetXfer (&glDmaChHandle, CY_FX_GPIFTOUSB_DMA_TX_SIZE);
    if (apiRetStatus != CY_U3P_SUCCESS)
    {
        CyU3PDebugPrint (4, "CyU3PDmaChannelSetXfer failed, Error code = %d\n", apiRetStatus);
        CyFxAppErrorHandler(apiRetStatus);
    }

#ifdef LOOPBACK_AUTO

    /* Create the channels used for loop-back function. */
    dmaCfg.size           = 4096;
    dmaCfg.count          = 8;
    dmaCfg.prodSckId      = CY_FX_LOOP_PRODUCER_SOCK;
    dmaCfg.consSckId      = CY_FX_LOOP_CONSUMER_SOCK;
    dmaCfg.dmaMode        = CY_U3P_DMA_MODE_BYTE;
    dmaCfg.notification   = 0;
    dmaCfg.cb             = 0;
    dmaCfg.prodHeader     = 0;
    dmaCfg.prodFooter     = 0;
    dmaCfg.consHeader     = 0;
    dmaCfg.prodAvailCount = 0;
    apiRetStatus = CyU3PDmaChannelCreate (&glLoopOutChHandle, CY_U3P_DMA_TYPE_AUTO, &dmaCfg);
    if (apiRetStatus != CY_U3P_SUCCESS)
    {
        CyU3PDebugPrint (4, "CyU3PDmaChannelCreate failed, Error code = %d\n", apiRetStatus);
        CyFxAppErrorHandler (apiRetStatus);
    }

    apiRetStatus = CyU3PDmaChannelSetXfer (&glLoopOutChHandle, 0);
    if (apiRetStatus != CY_U3P_SUCCESS)
    {
        CyU3PDebugPrint (4, "CyU3PDmaChannelCreate failed, Error code = %d\n", apiRetStatus);
        CyFxAppErrorHandler (apiRetStatus);
    }

#else

    /* Create the channels used for loop-back function. */
    dmaCfg.size           = 4096;
    dmaCfg.count          = 4;
    dmaCfg.prodSckId      = CY_FX_LOOP_PRODUCER_SOCK;
    dmaCfg.consSckId      = CY_U3P_CPU_SOCKET_CONS;
    dmaCfg.dmaMode        = CY_U3P_DMA_MODE_BYTE;
    dmaCfg.notification   = CY_U3P_DMA_CB_PROD_EVENT;
    dmaCfg.cb             = LoopBackDmaCallback;
    dmaCfg.prodHeader     = 0;
    dmaCfg.prodFooter     = 0;
    dmaCfg.consHeader     = 0;
    dmaCfg.prodAvailCount = 0;
    apiRetStatus = CyU3PDmaChannelCreate (&glLoopOutChHandle, CY_U3P_DMA_TYPE_MANUAL_IN, &dmaCfg);
    if (apiRetStatus != CY_U3P_SUCCESS)
    {
        CyFxAppErrorHandler (apiRetStatus);
    }

    apiRetStatus = CyU3PDmaChannelSetXfer (&glLoopOutChHandle, 0);
    if (apiRetStatus != CY_U3P_SUCCESS)
    {
        CyFxAppErrorHandler (apiRetStatus);
    }

    dmaCfg.size           = 4096;
    dmaCfg.count          = 4;
    dmaCfg.prodSckId      = CY_U3P_CPU_SOCKET_PROD;
    dmaCfg.consSckId      = CY_FX_LOOP_CONSUMER_SOCK;
    dmaCfg.dmaMode        = CY_U3P_DMA_MODE_BYTE;
    dmaCfg.notification   = 0;
    dmaCfg.cb             = 0;
    dmaCfg.prodHeader     = 0;
    dmaCfg.prodFooter     = 0;
    dmaCfg.consHeader     = 0;
    dmaCfg.prodAvailCount = 0;
    apiRetStatus = CyU3PDmaChannelCreate (&glLoopInChHandle, CY_U3P_DMA_TYPE_MANUAL_OUT, &dmaCfg);
    if (apiRetStatus != CY_U3P_SUCCESS)
    {
        CyFxAppErrorHandler (apiRetStatus);
    }

    apiRetStatus = CyU3PDmaChannelSetXfer (&glLoopInChHandle, 0);
    if (apiRetStatus != CY_U3P_SUCCESS)
    {
        CyFxAppErrorHandler (apiRetStatus);
    }

#endif

    /* Load and start the GPIF state machine. */
    apiRetStatus = CyU3PGpifLoad (&CyFxGpifConfig);
    if (apiRetStatus != CY_U3P_SUCCESS)
    {
        CyU3PDebugPrint (4, "CyU3PGpifLoad failed, error code = %d\n", apiRetStatus);
        CyFxAppErrorHandler (apiRetStatus);
    }

    apiRetStatus = CyU3PGpifSMStart (START, ALPHA_START);
    if (apiRetStatus != CY_U3P_SUCCESS)
    {
        CyU3PDebugPrint (4, "CyU3PGpifSMStart failed, error code = %d\n", apiRetStatus);
        CyFxAppErrorHandler (apiRetStatus);
    }

    /* Update the flag so that the application thread is notified of this. */
    glIsApplnActive = CyTrue;
}
