fabriciomicheldenes/Momea/Firmware/GpifToUsb_Clock_Separado/AppInit.c

/*
 * AppInit.c
 *
 *  Created on: 22/12/2024
 *      Author: FMichelD
 */

#include "AppInit.h"

/* This function initializes the USB Module, sets the enumeration descriptors.
 * This function does not start the bulk streaming and this is done only when
 * SET_CONF event is received. */
void
CyFxApplnInit (void)
{
    CyU3PReturnStatus_t apiRetStatus = CY_U3P_SUCCESS;
    CyU3PPibClock_t pibClk = {9, CyFalse, CyFalse, CY_U3P_SYS_CLK};

	apiRetStatus = CyU3PPibInit(CyTrue, &pibClk);
	if (apiRetStatus != CY_U3P_SUCCESS)
	{
		CyU3PDebugPrint (4, "P-port Initialization failed, Error Code = %d\n",apiRetStatus);
		CyFxAppErrorHandler(apiRetStatus);
	}

	CyFxApplnSetPibDllParameters (CyTrue, 1, 0, 11);

    /* Start the USB functionality. */
    apiRetStatus = CyU3PUsbStart();
    if (apiRetStatus != CY_U3P_SUCCESS)
    {
        CyU3PDebugPrint (4, "CyU3PUsbStart failed to Start, Error code = %d\n", apiRetStatus);
        CyFxAppErrorHandler(apiRetStatus);
    }

    /* The fast enumeration is the easiest way to setup a USB connection,
     * where all enumeration phase is handled by the library. Only the
     * class / vendor requests need to be handled by the application. */
    CyU3PUsbRegisterSetupCallback(CyFxApplnUSBSetupCB, CyTrue);

    /* Setup the callback to handle the USB events. */
    CyU3PUsbRegisterEventCallback(CyFxApplnUSBEventCB);

    /* Register a callback to handle LPM requests from the USB 3.0 host. */
    CyU3PUsbRegisterLPMRequestCallback(CyFxApplnLPMRqtCB);

    /* Set the USB Enumeration descriptors */

    /* Super speed device descriptor. */
    apiRetStatus = CyU3PUsbSetDesc(CY_U3P_USB_SET_SS_DEVICE_DESCR, 0, (uint8_t *)CyFxUSB30DeviceDscr);
    if (apiRetStatus != CY_U3P_SUCCESS)
    {
        CyU3PDebugPrint (4, "USB set device descriptor failed, Error code = %d\n", apiRetStatus);
        CyFxAppErrorHandler(apiRetStatus);
    }

    /* High speed device descriptor. */
    apiRetStatus = CyU3PUsbSetDesc(CY_U3P_USB_SET_HS_DEVICE_DESCR, 0, (uint8_t *)CyFxUSB20DeviceDscr);
    if (apiRetStatus != CY_U3P_SUCCESS)
    {
        CyU3PDebugPrint (4, "USB set device descriptor failed, Error code = %d\n", apiRetStatus);
        CyFxAppErrorHandler(apiRetStatus);
    }

    /* BOS descriptor */
    apiRetStatus = CyU3PUsbSetDesc(CY_U3P_USB_SET_SS_BOS_DESCR, 0, (uint8_t *)CyFxUSBBOSDscr);
    if (apiRetStatus != CY_U3P_SUCCESS)
    {
        CyU3PDebugPrint (4, "USB set configuration descriptor failed, Error code = %d\n", apiRetStatus);
        CyFxAppErrorHandler(apiRetStatus);
    }

    /* Device qualifier descriptor */
    apiRetStatus = CyU3PUsbSetDesc(CY_U3P_USB_SET_DEVQUAL_DESCR, 0, (uint8_t *)CyFxUSBDeviceQualDscr);
    if (apiRetStatus != CY_U3P_SUCCESS)
    {
        CyU3PDebugPrint (4, "USB set device qualifier descriptor failed, Error code = %d\n", apiRetStatus);
        CyFxAppErrorHandler(apiRetStatus);
    }

    /* Super speed configuration descriptor */
    apiRetStatus = CyU3PUsbSetDesc(CY_U3P_USB_SET_SS_CONFIG_DESCR, 0, (uint8_t *)CyFxUSBSSConfigDscr);
    if (apiRetStatus != CY_U3P_SUCCESS)
    {
        CyU3PDebugPrint (4, "USB set configuration descriptor failed, Error code = %d\n", apiRetStatus);
        CyFxAppErrorHandler(apiRetStatus);
    }

    /* High speed configuration descriptor */
    apiRetStatus = CyU3PUsbSetDesc(CY_U3P_USB_SET_HS_CONFIG_DESCR, 0, (uint8_t *)CyFxUSBHSConfigDscr);
    if (apiRetStatus != CY_U3P_SUCCESS)
    {
        CyU3PDebugPrint (4, "USB Set Other Speed Descriptor failed, Error Code = %d\n", apiRetStatus);
        CyFxAppErrorHandler(apiRetStatus);
    }

    /* Full speed configuration descriptor */
    apiRetStatus = CyU3PUsbSetDesc(CY_U3P_USB_SET_FS_CONFIG_DESCR, 0, (uint8_t *)CyFxUSBFSConfigDscr);
    if (apiRetStatus != CY_U3P_SUCCESS)
    {
        CyU3PDebugPrint (4, "USB Set Configuration Descriptor failed, Error Code = %d\n", apiRetStatus);
        CyFxAppErrorHandler(apiRetStatus);
    }

    /* String descriptor 0 */
    apiRetStatus = CyU3PUsbSetDesc(CY_U3P_USB_SET_STRING_DESCR, 0, (uint8_t *)CyFxUSBStringLangIDDscr);
    if (apiRetStatus != CY_U3P_SUCCESS)
    {
        CyU3PDebugPrint (4, "USB set string descriptor failed, Error code = %d\n", apiRetStatus);
        CyFxAppErrorHandler(apiRetStatus);
    }

    /* String descriptor 1 */
    apiRetStatus = CyU3PUsbSetDesc(CY_U3P_USB_SET_STRING_DESCR, 1, (uint8_t *)CyFxUSBManufactureDscr);
    if (apiRetStatus != CY_U3P_SUCCESS)
    {
        CyU3PDebugPrint (4, "USB set string descriptor failed, Error code = %d\n", apiRetStatus);
        CyFxAppErrorHandler(apiRetStatus);
    }

    /* String descriptor 2 */
    apiRetStatus = CyU3PUsbSetDesc(CY_U3P_USB_SET_STRING_DESCR, 2, (uint8_t *)CyFxUSBProductDscr);
    if (apiRetStatus != CY_U3P_SUCCESS)
    {
        CyU3PDebugPrint (4, "USB set string descriptor failed, Error code = %d\n", apiRetStatus);
        CyFxAppErrorHandler(apiRetStatus);
    }

    /* Register a buffer into which the USB driver can log relevant events. */
    gl_UsbLogBuffer = (uint8_t *)CyU3PDmaBufferAlloc (CYFX_USBLOG_SIZE);
    if (gl_UsbLogBuffer)
        CyU3PUsbInitEventLog (gl_UsbLogBuffer, CYFX_USBLOG_SIZE);

    CyU3PDebugPrint (4, "About to connect to USB host\r\n");

    /* Connect the USB Pins with super speed operation enabled. */
    apiRetStatus = CyU3PConnectState (CyTrue, CyTrue);
    if (apiRetStatus != CY_U3P_SUCCESS)
    {
        CyU3PDebugPrint (4, "USB Connect failed, Error code = %d\n", apiRetStatus);
        CyFxAppErrorHandler(apiRetStatus);
    }
    CyU3PDebugPrint (8, "CyFxApplnInit complete\r\n");

}
