fabriciomicheldenes/Momea/Firmware/GpifToUsb_Clock_Separado/AppDefine.h

/*
 * AppDefine.h
 *
 *  Created on: 22/12/2024
 *      Author: FMichelD
 */

#ifndef APPDEFINE_H_
#define APPDEFINE_H_

#include "cyfxgpiftousb.h"
#include "ThreadEntry.h"

/* Application define function which creates the threads. */
void
CyFxApplicationDefine (
        void);

#endif /* APPDEFINE_H_ */
