fabriciomicheldenes/Momea/Firmware/GpifToUsb_Clock_Separado/ErrorHandler.c

/*
 * ErrorHandler.c
 *
 *  Created on: 22/12/2024
 *      Author: FMichelD
 */

#include "ErrorHandler.h"

/* Application Error Handler */
void
CyFxAppErrorHandler (
        CyU3PReturnStatus_t apiRetStatus    /* API return status */
        )
{
    /* Application failed with the error code apiRetStatus */

    /* Add custom debug or recovery actions here */

    /* Let's do a device reset here. */
    CyU3PThreadSleep (100);
    CyU3PDeviceReset (CyFalse);

    /* Loop Indefinitely */
    for (;;)
    {
        /* Thread sleep : 100 ms */
        CyU3PThreadSleep (100);
    }
}
