fabriciomicheldenes/Momea/Firmware/GpifToUsb_Clock_Separado/ErrorHandler.h

/*
 * ErrorHandler.h
 *
 *  Created on: 22/12/2024
 *      Author: FMichelD
 */

#ifndef ERRORHANDLER_H_
#define ERRORHANDLER_H_

#include "cyfxgpiftousb.h"

/* Application Error Handler */
void
CyFxAppErrorHandler (
        CyU3PReturnStatus_t apiRetStatus    /* API return status */
        );

#endif /* ERRORHANDLER_H_ */
