fabriciomicheldenes/Momea/(commit log)

2024-12-18 Move o código-fonte do MomeaCapture para diretório apropriado
2024-12-18 Adiciona o exemplo de como Controlar a Geração de clock
2024-12-18 Adiciona o exemplo de como Controlar um led usando Comandos USB
2024-12-18 Adiciona o projeto da placa MomeaProbe12
    [Ae_System_12Bits_V5.csv, Ae_System_12Bits_V5.dsn, Ae_System_12Bits_V5.kicad_sch, Amp Gain Configs.kicad_sch, Amplificador.kicad_sch, ConversorAnalogicoDigital.kicad_sch, ConversorAnalogicoDigital_A.kicad_sch, ConversorAnalogicoDigital_B.kicad_sch]
2024-12-18 Adicionado informações sobre as etapas eletrônicas
    [Amplificador.kicad_sch, Fonte.kicad_sch]
